SeanCoaker/Masters-Group-Project/Documentation/Milestone 3/chapter/design.tex

\chapter{Design}
        \label{ch:design}
        
            This chapter details the design decisions made for the project's hardware and software systems, which ultimately led to us being able to successfully implement our systems and meet the original requirements set out by our clients. The following sections will break down our final product into two systems, the walking aid device and the wearable device, detailing the design decisions made for each system, including which technologies were used and UML diagrams of the systems. We will begin by detailing the design choices we made that impact both systems before breaking down our design decisions that individually impact the walking aid and wearable devices.
        
            \section{Walking Aid Device}
            \label{sec:walking_aid}
        
                The walking aid device is a system that can be used to detect the movement of the walking aid. When the wearable device detects that the patient is walking, a message is sent to the walking aid device. Should the walking aid device detect that it is not moving when the patient is walking, it will play an audio reminder to the patient to take their walking aid with them. The following sections will detail the design choices we made for this system, where we will compare technologies that would have been suited to the system and which we chose to implement, as well as a UML design section which will include a class diagram of the developed software system and an activity diagram that demonstrates the workflow of the software that allows the device to meet our desired specification.
        
                \subsection{I2S Audio Shield}
                \label{subsec:i2s_audio_shield}
        
                    To handle the amplification of reminder audio files and transfer the analogue data of the reminder audio to an external speaker, we needed to select an audio shield. In this instance we selected the I2S Audio Shield \cite{unexpected_maker} on offer from Unexpected Maker, the creator of the TinyPICO development board that has been previously mentioned in section \ref{subsec:development_board}. What attracted the team to using this particular audio shield was the fact that it already included the necessary hardware for handling the audio reminder system. That is that it contains a micro-SD card slot for the reading of the user's reminder audio file, external speaker output pins, and an amplifier to increase the volume of the audio in readiness to be transferred to the external speaker. With all these hardware devices housed on one audio shield, it made the design of the walking aid device casing more simple than an alternative that may have needed separate modules for the amplification of audio and the reading of a microSD card. In addition to this, we assumed that acquiring separate hardware items from the same manufacturer would lead to a greater chance of our hardware devices communicating flawlessly with each other. To this end, we have not experienced any issues with the communication between the walking aid's TinyPICO and its audio shield. Therefore, we would say that in this instance, our assumption was correct.
                    
                    Alternative solutions could have taken the form of utilising the same ``MAX98357 I\textsuperscript{2}C Decoder and Amp'' \cite{unexpected_maker} as the one used by the I2S Audio Shield we selected but instead combining it with a separate dedicated micro-SD card reader, such as this offering \cite{ada_2022} from the well known embedded hardware manufacturer, Adafruit. The wiring and code development in this instance would have been identical, but we appreciated the fact that the Unexpected Maker solution houses the I\textsuperscript{2}C decoder and amplifier on the same board as the microSD card reader. Along with this, the I2S audio shield is of a similar form factor to the TinyPICO development board and made the 3D modelling and printing process a simpler process.
        
                \subsection{SD Card Reading Library - SdFat}
                \label{subsec:sdfat}
        
                    The decision to use the SdFat library by Bill Greiman \cite{greiman} was an unexpected one as Arduino provides a solution of SD card reading library \cite{arduino} which acts as a wrapper to the SdFat library for easier understanding and further abstraction of the underlying code. However, when testing the transfer of a 150 KB mp3 file to the SPIFFS storage location of the TinyPICO, we began to notice that the library was taking an abnormally long time to complete the process, especially with a file this small. Upon completing research on the transfer speeds of the Arduino SD library, it was clear to see that the library had not been tested or optimised adequately enough to be used for the fast transferring of audio files from the microSD card to SPIFFS within our walking aid device. Discussion of these issues is widespread \cite{fat16lib_2011,drdooom_2019} with one GitHub user claiming that the SdFat library is ``85 times faster'' \cite{kas2_2018} than the Arduino SD library. Our testing demonstrated transfer times of the 150 KB mp3 file from the microSD card to SPIFFS at around 150 seconds for the Arduino SD library, and around 12 seconds for the SdFat library. More information on this is viewable within the testing section of this document. But with such a stark difference in transfer rates, and with fast transfer rates being crucial for the prompt initialisation of our systems, we felt that the SdFat library was the most appropriate solution for our purposes.
        
                \subsection{Physical Design}
                \label{subsec:Design_Decisions_walking_aid}
        
                    Upon clarifying the physical needs and requirements of the device, it was decided that the walking aid device had to be adaptable between different walking aids, such as a walking sticker or Zimmer frame. The form factor was an especially important priority, as a small/minimal footprint would minimise any potential problems or complications with the users. With this in mind, and with components at hand, the design was made with minimal overhead over the physical size of the items we had at hand. 
        
                    \input{graphics/cad/walkingaid_0.tex}
        
                    The design was made as modular as possible, to allow for changeable parts, and to make it inter-operable for different walking aids and mounting/battery options. The mounting options were inspired by the GoPro style of handlebar mount, this was chosen due to its simplicity, and the sturdiness of attachment which will help with the reading from our accelerometers. The mount was scaled down to be more appropriately attached to a walking stick or Zimmer frame, but as mentioned can be easily swapped and modified to work with bigger or smaller tubes/frames.
        
                    To fulfil the specification, and allow for familiar voices to remind the users, a MicroSD card was chosen as described above. This required easy access to the card slot, which had to be intuitive and accessible without disassembly of the device.
        
                    \input{graphics/cad/walkingaid_0_1.tex}
        
                    Further considerations include easy access to the MicroUSB port. This port is required for programming/updating the device, as well as being an option for powering the device if no battery is wanted/needed, or a 5v source is available (such as a large, portable power bank).
        
                    As noted, the current prototype has no battery support, but the design decision for this walking aid device is to offer swappable end cases, this helps with modularity to allow for different mounts and attachments, but with a through-hole for wiring, this allows for future implementations of battery-based sources, such as replaceable batteries or rechargeable internal cells.

                \subsection{Prototype}
                \label{subsec:prototype_walking_aid}
        
                    As with the wearable device, assembly was made using standard M3 sized bolts, this time 35mm long to ensure suffcient length to attach the the front and rear endcasing to the midframe. This designed allows assembly to be done rather easily, and again utilising the self-tapping capabilities of the ABS plastic to retain the screws.
        
                    Before assembly, the speaker wires had to be attached to the terminal of the Audio Shield, as the TinyPico would block access to it later on in assembly. The wires had to be fed through the access hole in the midframe, to allow access as well as boost the internal area that the speaker can leverage for stronger sound.
        
                    \input{graphics/prototype/walkingaid_1.tex}
        
                    The front encases the 40mm driver, and the 4 screws attach it to the midframe securely without further adhesives, initially we had thought that spacers may be needed to stop unnecessary movement, but we instead opted for friction fit tolerances during design, which allowed for this step to be skipped and for an easier assembly process. The original speaker wiring is used, to ensure the correct gauge and rating is used and therefor safe.
        
                    The TinyPico with the accompanying soldered ADXL wiring is then added to the assembly. Side brackets are included in the complex midplate, that stop the boards from moving inside the casing. This is critical as we did not want internal movement to affect the sensitive accelerometer, and due to the SD Card and MicroUSB port requiring precise cutouts in order to remain accessible.
        
                    \input{graphics/prototype/walkingaid_2.tex}
        
                    The rear endcasing can then be attached, in the same manner as the front casing. This self taps into the designed screw holes, and ensures that both sides of the device are securely clamped and in place.

                \subsection{UML}
                \label{sec:uml_walk_aid}
                
                    This section will break down the software systems utilised in the walking aid device into formal language representations. These will take the form of a class diagram, which will illustrate the relationships between each of the classes developed for the system, and an activity diagram which will demonstrate the sequence of events that will take place in the system and how they are handled. We hope that this section will help the reader to understand the software system in a broken down, step-by-step manner and to gain an understanding of our rationale for programming choices that helped us to fulfil the user requirements. The class diagrams will be followed by an explanation of the role of each class and its functions, with the activity diagram also being accompanied by a body of text that establishes in natural language the sequence of events that will take place in the software system and how they are processed.
        
                    \subsubsection{Class Diagram}
                    \label{subsubsec:class_diagram_walking_aid}
        
                        To demonstrate how the classes within the software are laid out and how they communicate with one another to make up the whole system, we include here a class diagram. Following the class diagram, we will include documentation on each class and their functions towards benefiting the functionality of the system. 
        
                        \clearpage
                        \thispagestyle{empty}
                        \begin{landscape}
                            \input{graphics/walking_aid_uml.tex}
                        \end{landscape}
        
                        \paragraph{WalkAidSketch}\mbox{}
        
                            This is the main controller of the whole walking aid system and provides the functionality of the setup and loop functions that are required by Arduino systems. It has a composition relationship with the WalkAidAccelerometer, WalkAidCommunications, and the WalkAidAudio classes. Thus, the WalkAidSketch class cannot function without the existence of those classes, and those classes cannot function without the existence of the WalkAidSketch class. The WalkAidSketch class handles the initialisation of the other classes within the setup function, before ensuring that each time the loop function is called, checks are made to see if reminder messages have been received and if so, are responded to accordingly.
        
                        \paragraph{WalkAidAccelerometer}\mbox{}
        
                            The WalkAidAccelerometer class is responsible for the initialisation of the accelerometer, and the reading of the accelerometer data. The class keeps track of when a step was last taken to avoid the audio reminder being played if the walking aid is moving. It has a composition relationship with the ADXL345 class meaning that neither class could function properly without the existence of the other. This class also relies on the existence of the WalkAidSketch to exist itself.
        
                        \paragraph{WalkAidCommunications}\mbox{}
        
                            The WalkAidCommunications class is responsible for the initialisation of the ESP-Now communication protocol to establish a connection to the wearable device. When a reminder message is received, the reminder variable is set to true to allow the WalkAidSketch to check for a step in the previous period of time or in the future period of time. Should a reminder need to be played but the user is deaf, this class will send a message back to the wearable device prompting it to vibrate. This class is initialised in the WalkAidSketch class and does not exist unless that class exists. Therefore, it is part of a composition relationship with the WalkAidSketch.
        
                            The WalkAidCommunications class also makes use of the DebugLED class to ensure that the user is notified of any issues in initialising the communications protocol on boot. It has a composition relationship with the DebugLED class to allow for the LED to be configured should an error occur with the initiation of the communication protocol.
        
                        \paragraph{DebugLED}\mbox{}
        
                            The DebugLED class exists to handle the configuration of the TinyPICO's onboard LED to indicate whether the communication protocol is working or not. It is initialised in the WearableDeviceSketch class and is, therefore, part of a composition relationship with the WearableCommunications class. More specifically, an instance of the DebugLED class cannot exist without an instance of the WearableCommunications class.
        
                            The DebugLED class also holds a composition relationship with the TinyPICO helper library to allow for the configuration of the LED.
        
                        \paragraph{WalkAidAudio}\mbox{}
        
                            This class handles the initialisation of the SDToSPIFFS class to allow for the transferring of an audio SD file to the SPIFFS memory. Afterwards, it initialises all the necessary classes to interpret the mp3 audio file and play it. This class creates pointers to the AudioFileSourceID3, AudioFileSourceSPIFFS, AudioGeneratorMP3, and AudioOutputI2S classes. It has an aggregation relationship with these classes as it is responsible for their deletion due to them being pointer variables. It also holds a composition relationship with the SDToSPIFFS class, which is utilised for the transferring of the audio file from the SD card to the SPIFFS storage. 
        
                        \paragraph{SDToSPIFFS}\mbox{}
        
                            This class is responsible only for the transferring of the SD card audio file to the SPIFFS storage. It is part of a composition relationship with the WalkAidAudio class, due to it relying on being initialised in that class to exist. It also holds a composition relationship with the SdFat class, which we discussed in section \ref{subsec:sdfat}, to handle the more intricate SD card functions. 
                        
                        \newpage
        
                    \subsubsection{Activity Diagram}
                    \label{subsubsec:walking_aid_activity}
        
                        The following is an activity diagram that demonstrates the workflow of the walking aid software system. It demonstrates in a graphical way how the system operates in a step-by-step manner. Accompanying the activity diagram will be a body of text that will describe the overview of the activity diagram in natural language.
        
                        \input{graphics/walking_aid_activity.tex}
                    
                        The system begins as soon as the device is powered on. The first process that the system runs is the transferral of the SD audio file to the SPIFFS storage location for quicker access later on. If an error is detected with the process of transferring the audio file from the SD card to SPIFFS, then the system is left in a non-functional state. The system then attempts to initialise the ESP-Now communication with the wearable device. If this is unsuccessful then it will sit in an inactive state. Otherwise, it will attempt to initialise the accelerometer and begin the loop function of the sketch. 
        
                        For each pass of the loop function, the system first checks to see if a reminder message has been received from the wearable device. This message states, ``The wearable device is moving, is the walking aid device moving also?''. At this stage, the system checks if the time of the last detected step happened within the last developer's set period of time. If a step had been detected in that time, then we skip to the end of the loop and check again for movement in the walking aid to update the last time a movement was detected. Otherwise, we then run a loop for the developer set period of time to check if movement is then detected. This allows the user time to get to their walking aid before having a reminder played or a vibration played through the wearable device. If movement was not detected in that period of time, then we play the audio reminder or send a vibrate message to the wearable device if the user is deaf. If movement was detected then we skip playing the audio or sending a vibrate message and move to the end of the loop. In all instances, the end of the loop signifies that the check for movement should occur again. As previously stated, this is to update the timestamp of the last movement detected. Once this is complete, we move back to the check for reminder message step to start the loop again.
        
                        To terminate the execution of the system prematurely, the device can be powered off. We may not have followed the etiquette of activity diagrams to demonstrate this, but we wanted to demonstrate that the system remains functional in a constant loop unless the device is powered off. We added a second initial activity of turning off the device to demonstrate this, where a power off device activity is run and we finish in a state where the device is powered off and non-functional.
                    
            \section{Wearable Device}
            \label{sec:wearabledevice}
        
                The wearable device can be worn on the limbs of the patients to identify when the patient has begun walking. When walking is detected, communication occurs between the walking aid and wearable device to identify if the walking aid device is moving also. 
        
                \subsection{Walking Detection Technique - Single-Tap Detection}
                \label{subsec:walking_detection_technique}
        
                   With the movement detection of the walking aid device, it was an obvious decision to utilise the single-tap detection feature of the ADXL345 accelerometer. We assume that the walking aid will take the form of a walking stick or Zimmer frame-like structure, with movement likely to include lifting and placing. The placing event will cause a change in gravity through the Z-Axis of the accelerometer, and thus will allow the accelerometer to notice a tap is detected.
        
                   The decision of what system to use to detect movement in the wearable device was less simple. Options included using a similar single-tap detection system, a system that utilises changes in acceleration to detect walking or a system that uses the Bluetooth Low Energy (BLE) technology of each device to measure changes in distances between them. With the option of utilising BLE technology to detect walking, we would have needed to also utilise an accelerometer on one of the devices still to gain an understanding of which device was moving. However, the use of BLE technology for this use case would have been inadequate due to its potential for distance calculation inaccuracies of up to several metres \cite{Fachri_2019}. 
        
                   Therefore, we were left with using the ADXL345 accelerometer for the detection of the user walking. To decide on which solution of accelerometer system to use, we decided to develop both the single-tap detection system and the acceleration change detection system and compare them in real-world testing. For our system, the single-tap detection system seemed to work better in attempting to detect walking, whereas the system attempting to detect changes in acceleration struggled with also detecting any movements in the accelerometer. The single-tap detection system would also be beneficial to us as it would be implementable on both the walking aid and wearable devices. Another benefit to the single-tap detection solution is that it allows versatility as to where the wearable device can be placed, with testing proving that the devices can detect walking on both the user's wrist and their ankle. 
        
                   Ultimately, we decided to implement the single-tap detection system within the wearable device to detect when the user was walking. We make use of a system that checks if the user makes 5 steps within 10 seconds to meet the user requirement of reminders only being played if the user has moved over a metre without their walking aid. If they do, then we send a message to the walking aid device to play an audio reminder to the patient to take their walking aid with them if the walking aid device has not detected movement. The main benefit of this system is its versatility to be worn on the user's wrist or ankle, and it provided the foundations for the similar system that has been developed for the walking aid device. In future, we would like to explore the use of the aforementioned ultra-wideband technology (UWB). Due to its distance measurement error being within 10 cm \cite{uwb_accuracy}, it would have been interesting to implement this within the wearable device, and into the walking aid device working in conjunction with an accelerometer to detect if the walking aid is moving.
        
                \subsection{Physical Design}
                \label{subsec:Design_Decisions_wearable}
        
                    As with the walking aid device, the design was formulated around a minimalistic form factor around the components that needed to be present, in this case, the TinyPico, ADXL, and vibration motor. This prototype needed to be of a particularly small form factor; the client made it clear that patients aren't always happy with new, large and obtrusive objects on their bodies, so the more natural we could make it, the better it would be. This device is very tightly packed, with the components in very short distances of one another, although this could be an issue with electrical shorts, during assembly there will be insulating factors included, that will stop this from happening.
        
                    \input{graphics/cad/wearable_components_1.tex} %%also includes endcase
        
                    A similar approach was taken regarding the modular design, with an end-housing that can be quickly and easily changed. We designed a base end-plate from which all attachments are based, and will include it in the deliverables to ensure the client can adjust and create more as needed from our working template.
        
                    \input{graphics/cad/wearable_0.tex}
        
                    We have designed and printed two different mounting options to begin with, the first being a "clip-on" style attachment, that allows the wearable device to be clipped into pockets, clothing, or existing bands or straps the user may be wearing. This was designed to be a tight, friction fit between the casing and the clip, to ensure there is less chance of the item becoming loose over time.
        
                    \input{graphics/cad/wearable_clip_0.tex}
        
                    The second attachment option is a watch strap mount. This allows the wearable device to be used with any standard 22mm watchstrap, and the idea behind this is to allow for a more comfortable, and familiar feel on the arm. Patients aren't always happy trying new things due to their condition, but this should allow for existing watch straps to be used, and make them feel at home with their new device.
        
                    \input{graphics/cad/wearable_strap_0.tex}
        
                \subsection{Prototype}
                \label{subsec:Prototype_wearable}
        
                    The prototype was assembled using M3x8 stainless steel screws, which allowed for easy assembly and self-tapping into the soft interior plastic, which was toleranced for this. In the future, it would be ideal to use heat-set inserts, to ensure the longevity of the threading.
        
                    \input{graphics/prototype/wearable_0.tex}
        
                    The wiring and soldering were done before assembly, with approximate but accurate measurements of 26awg silicone wire, to allow for a minimal form factor and to fit in the small enclosure. Silicone wire was used to ensure tight bends and cable management could be achieved.
        
                    \input{graphics/prototype/attachments.tex}
        
                    We have created the two available attachments, as previously described, a clip that can be worn on any existing bands, pockets or clipped directly to clothing/sleeves. Also shown is the watch strap attachment, without the device to show off the geometry of the design
        
                    \input{graphics/prototype/watchstrap_0.tex}
        
                    Shown above is the wrist strap attachment, which allows the use of regular 22mm watch bands, using standard push pin connectors. This allows the patient to be more comfortable, and use existing watch straps they may already own and be accustomed to.

                \subsection{UML}
                \label{sec:uml_wearable}
                
                    This section will break down the software systems utilised in the walking aid device into formal language representations. These will take the form of a class diagram, which will illustrate the relationships between each of the classes developed for the system, and an activity diagram which will demonstrate the sequence of events that will take place in the system and how they are handled. We hope that this section will help the reader to understand the software system in a broken down, step-by-step manner and to gain an understanding of our rationale for programming choices that helped us to fulfil the user requirements. The class diagrams will be followed by an explanation of the role of each class and its functions, with the activity diagram also being accompanied by a body of text that establishes in natural language the sequence of events that will take place in the software system and how they are processed.
        
                    \subsubsection{Class Diagram}
                    \label{subsubsec:class_diagram_wearable}
        
                        Similarly to the walking aid device section, this section will include the class and activity diagrams of the wearable device. Each diagram will be accompanied by a body of text that explains the diagram in a natural language format.
        
                        \clearpage
                        \thispagestyle{empty}
                        \begin{landscape}
                            \input{graphics/wearable_uml.tex}
                        \end{landscape}
        
                        \paragraph{WearableDeviceSketch}\mbox{}
        
                            This is the main sketch for the wearable device system and implements the setup and loop functions necessary for an Arduino system. It creates instances of the WearableAccelerometer and WearableCommunications class to provide the full functionality of the wearable device. The setup function initialises both classes with the developer's selected parameters. Following this, the loop function handles the calls to check if the user has moved more than 5 steps within a period of time set by the developer. If they have, then the communications object is called to handle the broadcasting of a reminder message to the walking aid device.
        
                            The WearableDeviceSketch has a composition relationship to both of the other classes as it plays the role of instantiating both objects. Therefore, without the existence of the WearableDeviceSketch, an object of the other two classes would not exist.
        
                        \paragraph{WearableCommunications}\mbox{}
        
                            The WearableCommunications class handles all the functionality needed to broadcast a message to the walking aid device. Once it is initialised by the WearableDeviceSketch class with a reminder message to send and a MAC address to send the message to, its sendReminderMessage function can be called to broadcast a reminder message when the user has walked more than 5 steps in a specified period of time set by the developer. It is also initialised with the details of the walking aid device as a peer to allow incoming communication. The WearableCommunications class has a composition relationship with the DebugLED class to allow for the LED to be configured should an error occur with the initiation of the communication protocol.
        
                            This class is also part of a composition relationship with the WearableDeviceSketch class and therefore an object of it cannot exist unless the WearableDeviceSketch class is instantiated.
        
                        \paragraph{DebugLED}\mbox{}
        
                            The DebugLED class exists to handle the configuration of the TinyPICO's onboard LED to indicate whether the communication protocol is working or not. It is initialised in the WearableDeviceSketch class and is, therefore, part of a composition relationship with the WearableCommunications class. More specifically, an instance of the DebugLED class cannot exist without an instance of the WearableCommunications class.
        
                            The DebugLED class also holds a composition relationship with the TinyPICO helper library to allow for the configuration of the LED.
        
                        \paragraph{WearableAccelerometer}\mbox{}
        
                            Controlling the functionality of the walking detection, this class utilises the ADXL345 accelerometer library to detect single-taps or gravitational changes through the accelerometer. Once it is initialised with threshold values and a value for the period of time used to check for 5 steps, the poll function can be called by the WearableDeviceSketch to check for steps. Each time a step is detected, the addStepToCounter function is called to add to the total number of steps detected. If a step is detected, and it has taken more than the period of time since the first step is detected, then the timer is reset. Otherwise, if the step counter is incremented and is still less than 5 steps, then we move on. However, if the step counter reaches 5 steps within the developer set period of time, then a true boolean value is returned to the WearableDeviceSketch to notify it that a reminder message should be sent to the walking aid device.
        
                            The class holds a composition relationship with the ADXL345 library to retrieve the necessary functionality for step detection. This class is also part of a composition relationship with the WearableDeviceSketch class, meaning that if an instance of the WearableDeviceSketch class does not exist then neither will an instance of this class. 
        
                        \newpage
        
                    \subsubsection{Activity Diagram}
                    \label{subsubsec:wearable_activity}
        
                        The following is an activity diagram that demonstrates the workflow of the wearable software system. The diagram demonstrates how the system attempts to detect that the user is walking in a step-by-step manner to provide clarity on how the software was developed for these purposes. Accompanying the diagram will be a body of text that describes the process in natural language.
        
                        \input{graphics/wearable_activity.tex}
        
                        The activity diagram demonstrates that the system begins when the device is powered on. The system begins by initialising the accelerometer with the configurations of the developer before attempting to initialise the ESP-Now communications protocol and registering the walking aid device as a peer for communication. If either of the ESP-Now steps fail then we end up in a state where the device is powered on but is not functional. 
        
                        If the communication initialisation is successful, then we begin the process of attempting to identify when the user is walking. We begin first by checking for a step, which checks if the accelerometer has detected a change in gravity. If it has not detected a step, then we loop back and check for a step again until we identify one. Otherwise, we increment the step counter before checking to see if the timer has started and if it has, then we check to see if the time since the first step was detected is greater than the period of time set by the developer. If the timer has not been started, or it has been greater than the developer specified period of time since the first step, we reset the timer and set the step counter back to 1 and start the check for step process again. Otherwise, we run a check to see if the step counter is now at 5 steps. If it is not, then we loop back to the beginning of the check for the step counter. If the step counter is indeed equal to 5, then we have reached the situation where the user has moved a considerable amount in the period of time set by the developer. We can therefore ascertain that the user is walking and send a reminder message to the walking aid device to check if the walking aid is moving as well.
        
                        Finally, despite not following activity diagram etiquette, we wanted to demonstrate how powering off the system is the only way to stop the device from being functional. The existence of a second initial activity that controls the powering off of the system demonstrates this and demonstrates how the rest of the system relies on the device being powered on.
        
            \section{Walking Aid \& Wearable Device Design Commonalities}
            \label{sec:both_devices}
        
                This section will contain information on the design decisions we made that impacted both the wearable and walking aid devices. This will include software and hardware decisions that allowed us to implement a communications system, that allowed us to keep device form factor and power usage to a minimum and a discussion of why we chose pieces of hardware that are common between both devices.
        
                \subsection{Development Board - TinyPICO}
                \label{subsec:development_board}
        
                    The development board for each device would provide the necessary communication between multiple hardware components to allow us to reach the originally defined user requirements. Due to our previous experience with ESP32 chips and due to the necessity of our devices being of a small enough form factor to fit on the limbs of patients and walking aids, we decided to use the TinyPICO development boards. Their use of ESP32 chips provides the basis for our communication system which utilises a Wi-Fi module and provides adequate pinouts to allow us to communicate to each hardware device that we include within our systems. This is all achieved whilst keeping power usage to a minimum and allowing us to meet the client's requirement of creating devices that can operate for a substantial amount of time without the need for battery replacements. The 240MHz dual-core chip that is the ESP32, would provide performance that allows our system to react to incoming communication from the Wi-Fi module or accelerometer promptly to provide a responsive system for our clients. The vast documentation supporting the development of embedded systems using ESP32s was instrumental in the success of our project, and we feel that the decision to utilise TinyPICO development boards was the correct one because of this. We were also influenced to use TinyPICO development boards due to Swansea University allowing us to borrow two boards at no extra cost, which ultimately allowed us to remain within our £150 budget. Finally, the TinyPICO boards also provide a built-in LED which we utilised throughout project development for debugging purposes.
        
                \subsection{Programming Language - Arduino C (C/C++)}
                \label{subsec:programming_language}
        
                    We decided to utilise the Arduino C (C++) programming language rather than using MicroPython to develop our embedded software due to C++'s superior efficiency over Python for the development of embedded software \cite{github_2014, dicola}. Other tools such as PlatformIO would have provided the basis to allow us to utilise C++ for our software development, but due to the benefits of our team having previous experience of using the Arduino IDE to develop embedded systems, especially in the field of software development with ESP32 chips, we felt that our project would be better suited to being developed utilising the Arduino ecosystem. We were also aware that the handover of this project would mean that another team would be able to take on the role of advancing our code and felt that C++ provided the best platform for developing smaller and more self-explanatory code across multiple header and implementation files. This would mean that any developers that attempt to further develop our code in future, should find it rather simple to identify what each class and block of code is attempting to accomplish.
        
                \subsection{Accelerometer - Adafruit ADXL345}
                \label{subsec:accel}
        
                    Within this project, the accelerometer would provide the basis for identifying the movement of the patient and the walking aid. The vast documentation supporting the development of embedded systems using ADXL345 accelerometers was a substantial factor in why we opted to include them in our systems. They provide the functionality for the detection of various changes in acceleration such as activity detection, free-fall detection and single-tap and double-tap detection. The single-tap detection feature of the ADXL345 provides the basis for movement detection on both devices since it can detect changes in gravity to identify when a step has been taken. The single-tap detection feature also allows the system to still be utilised whether the user is wearing the wearable device on their wrist or ankle, with the single-tap detection feature also being able to detect when the walking aid is being lifted and placed back on the ground. The free-fall detection feature provided by the ADXL means that future developers will be able to easily implement a free-fall detection system, which would allow the client to have their stretch goal implemented into the project. We opted to use the ADXL345 over other accelerometers as it is one of the newer offerings of accelerometers from the well renowned and reliable brand, Adafruit. Because of this, the accelerometers were relatively easy and quick to source, whilst only costing £7 per unit and allowing us to remain within our £150 budget. Finally, with the walking aid's TinyPICO already having its Serial Peripheral Interface and 3.3V power pinouts being utilised by the I2S audio shield, the ADXL345 allowed us to use the TinyPICO's I\textsuperscript{2}C interface for communication between the accelerometer and the development board and allowed us to use the 5V pinout provided by the TinyPICO to power the ADXL345 due to its built-in voltage regulator.
        
                \subsection{Communication Protocol - ESP-Now}
                \label{subsec:esp_now_comms}
        
                    Within the details specified in our Milestone 2 interim progress report, we classified the advantages and disadvantages of various options for communication protocols for use within our project. The first of those communication protocols was ESP-Now, a communication technology developed by the creators of the ESP32 chip, Espressif, which utilises the ESP32's Wi-Fi module to communicate with other devices that contain ESP32 chips \cite{esp-now_overview}. The other two communication protocol options we could have utilised were Bluetooth Low Energy (BLE) and Ultra-wideband (UWB). Despite considerations to include the use of UWB within our project, it would have been far too expensive for us to implement, and thus we instantly rejected the notion of using UWB within our project. Therefore, we were left with a decision to either utilise BLE or ESP-Now for the communication standard between our walking aid and wearable device. For the rest of this section, we will detail the advantages and disadvantages of using ESP-Now for our communication system, with comparisons to BLE, before finally detailing why we ultimately opted to utilise ESP-Now.
        
                    \newpage
                    \subsubsection{Advantages and Disadvantages of ESP-Now with comparisons to BLE}
                    \label{subsubsec:esp_now_advantages_disadvantages}
        
                        \vspace{2em}
                        \input{tables/nowTable.tex}
                        \vspace{5em}
        
                        We ultimately decided to use ESP-Now as our communication protocol due to its ease of implementation and since it allows sketch sizes to be smaller \cite{random_nerd_tutorials} than the sketch sizes of BLE \cite{kolban_2018}. The significance to sketch sizes being smaller is that they allow for the larger memory storage spaces accounting for larger audio reminder files, as well as providing more responsive code for what is a time-sensitive system. The lower throughput that ESP-Now provides in comparison to BLE should not be noticeable within our system because we only ever send one-word messages between our devices at a given time. However, the lower power efficiency of ESP-Now in comparison to BLE is a considerable disadvantage for use within this system. Having said this, ESP-Now is still regarded as being a low power solution and should still mean that the patient or carer will not need to remember to replace the batteries in their devices too often.

                \subsection{Power}
                \label{subsec: Power}
                    Our prototypes will not include any battery or portable power source support built-in, this decision was made due to the limited time and budget we had. Our vision, research and hardware support 1S Lithium Polymer (LiPo) batteries as standard and the TinyPico is designed to be used with this power source in mind. Unfortunately, researching safe battery charging circuits as well as proper battery care was not something we had the time for and will leave as an attainable stretch goal if this project were to gain further funding or time budgets.
        
                    1S LiPos are compact and offer excellent discharge currents which would make it ideal for our high wattage speaker, although adjusting speaker size can reduce the battery requirement quite significantly, and can be considered later on with further research and testing.
        
                    Our prototypes are powered by the same MicroUSB, 5V port that is used for programming and updating the device, to facilitate testing, these will run off of portable power banks with USB outputs, to ensure reliable voltage and amperage are provided to our devices to reduce potential issues during testing.
        
                \subsection{Prototyping}
                \label{subsec: Prototyping}
                
                    The software package used for designing the prototypes was chosen to be Autodesk Fusion 360 \cite{autodesk_2021}, as well as how pervasive it is within the 3D Printing community.
        
                    Where possible, we ensured that we used accurate existing models. This allowed us to make progress faster, as working out and modelling tight tolerances on PCB components wasn't always required. 
        
                    For the hardware that we could not find models for, such as the speaker, i2s audio shield, and vibration motor, critical dimensions were taken using Vernier callipers, and by cross-checking datasheets for each or similar devices.
        
                    For both devices, a large emphasis was placed on creating an enclosure for the electronics with a minimal, but modular form factor. As shown in their respective sections, the devices were designed to effectively house and protect the existing components, as well as allow for future expansion using modular systems and design choices, such as extendable mid plates and standard sized screws and fasteners.
        
                    Once designs for the enclosures were created, they were sliced and converted to gcode (file format used by 3D Printers, CNC routers, and other kinematic machines) using the open-source software package SuperSlicer \cite{merill_2022}, and then printed on a custom VoronDesign 0.1 CoreXY Fused Filament Deposition (FDM) 3D Printer. SuperSlicer was chosen due to our team's experience with the software, as well as already having a previously tuned profile for the machine.
        
                    The printing material was chosen to be Acrylonitrile butadiene styrene (ABS), a ubiquitous thermoplastic most often used with injection moulding in everyday objects due to its high impact resistance and thermal/chemical resistance. It used to be the plastic of choice for hobby-grade 3D Printing, however, it is becoming less common vs easier to print, and weaker/biodegradable plastics like Polylactic Acid (PLA) or Polyethylene terephthalate (PETG). We chose to continue with ABS, as our printer is cable of printing this more exotic material, and its properties will allow us to undertake stricter impact and resistance testing.             
                
            \newpage
        
            \section{Class Documentation - Walking Aid Device}
            \label{sec:class_documentation_walk_aid}\mbox{}
        
                \input{chapter/docs/walking_aid/sdtospiffs.tex}
                \newpage
                \input{chapter/docs/walking_aid/walkaidaccel.tex}
                \newpage
                \input{chapter/docs/walking_aid/walkaidaudio.tex}
                \newpage
                \input{chapter/docs/walking_aid/walkaidcomms.tex}
                \newpage
                \input{chapter/docs/walking_aid/debugled.tex}
                \newpage
                \input{chapter/docs/walking_aid/sketch.tex}
                \newpage
        
            \section{Class Documentation - Wearable Device}
            \label{sec:class_documentation_wearable}\mbox{}
        
                \input{chapter/docs/wearable/wearableaccel.tex}
                \newpage
                \input{chapter/docs/wearable/wearablecomms.tex}
                \newpage
                \input{chapter/docs/wearable/debugled.tex}
                \newpage
                \input{chapter/docs/wearable/sketch.tex}
                \newpage
