SeanCoaker/Masters-Group-Project/Documentation/Milestone 2/chapters/requirements.tex

\chapter{Requirements} \label{ch:Requirements}

In this section, we will include the functional and non-functional requirements from our Milestone 1 document \cite{coaker}. We will also include an extra column within the tables for both functional and non-functional requirements to detail what progress has been made towards implementing each requirement so far. These requirements were previously accepted by the client prior to the submission of our Milestone 1 document. Despite the issues and delays we have faced with the procurement of hardware, we believe that we are still on track to meet the requirements that we listed in our milestone 1 document \cite{coaker}. Therefore, we did not feel it necessary to make any amendments to our previously listed requirements. Our amended schedule in section \ref{chap:schedule} demonstrates our confidence in completing the work on time as well as demonstrating how important it was for us to complete development before and after we attained our full list of hardware.

\afterpage{%
    \clearpage% Flush earlier floats (otherwise order might not be correct)
    \thispagestyle{empty}% empty page style (?)
    \begin{landscape}% Landscape page
        \centering % Center table

        \section{Functional Requirements} \label{sec:func_requirements}
        \input{tables/f_reqs}

        \noindent
        \begin{tabularx}{0.9\linewidth}{rXXXXX}
           &\textsf{N/A}&\textsf{Started}&\textsf{Behind Schedule}&\textsf{Good Progress}
           &\textsf{Completed}\\[2mm]
           \textsf{FREQ1}       & \Mark{200}\\[-4mm]
           \textsf{FREQ2}    & \Mark{10}\\[-4mm]
           \textsf{FREQ3}    & \Mark{100}\\[-4mm]
           \textsf{FREQ4}   & \Mark{100}\\[-4mm]
           \textsf{FREQ5}       & \Mark{150}
        \end{tabularx}

        \pagebreak

        \section{Non-Functional Requirements} \label{sec:non_func_requirements}
        \input{tables/n_f_reqs}

        \noindent
        \begin{tabularx}{0.9\linewidth}{rXXXXX}
           &\textsf{N/A}&\textsf{Started}&\textsf{Behind Schedule}&\textsf{Good Progress}
           &\textsf{Completed}\\[2mm]
           \textsf{NONFREQ1}       & \Mark{200}\\[-4mm]
           \textsf{NONFREQ2}    & \Mark{150}\\[-4mm]
           \textsf{NONFREQ3}    & \Mark{150}\\[-4mm]
           \textsf{NONFREQ4}   & \Mark{200}\\[-4mm]
           \textsf{NONFREQ5}   & \Mark{200}\\[-4mm]
           \textsf{NONFREQ6}   & \Mark{200}\\[-4mm]
           \textsf{NONFREQ7}   & \Mark{150}\\[-4mm]
           \textsf{NONFREQ8}       & \Mark{10}
        \end{tabularx}

    \end{landscape}
    \clearpage% Flush page
}
% \vspace{1em} \input{./tables/f_reqs.tex} \vspace{5em}

% \section{Non-Functional Requirements} \label{sec:non_func_requirements}

% \vspace{1em} \input{./tables/n_f_reqs.tex} \vspace{5em}
