SeanCoaker/Masters-Group-Project/Documentation/Milestone 3/graphics/cad/walkingaid_0.tex

\begin{figure}[H]
\centering
\begin{minipage}{.5\textwidth}
  \centering
  
  \captionsetup{width=0.8\linewidth, justification=centering}
  \centering
  \captionof{figure}{Assembled walking aid device}
  \label{fig:walkingaid_1}
\end{minipage}%
\begin{minipage}{.5\textwidth}
  \centering
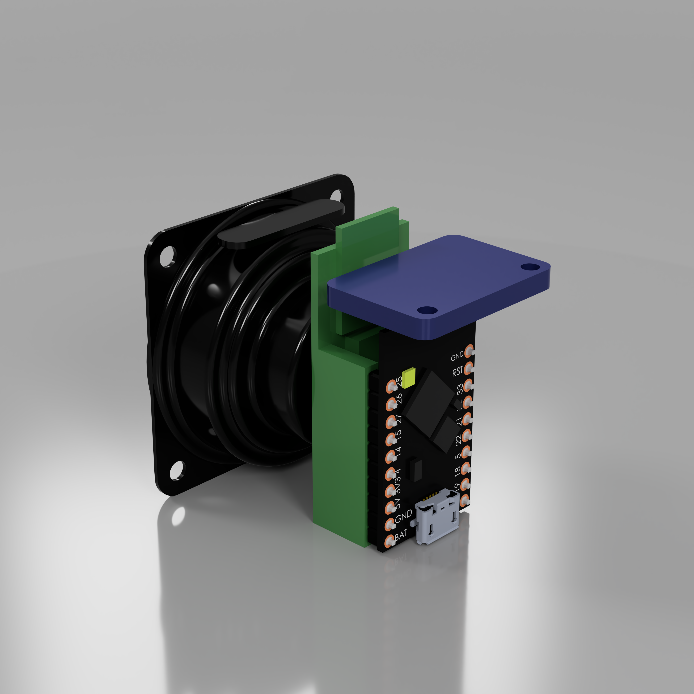
[picture p5: Documentation/Milestone 3/graphics/cad/walkingaid_components_1.png]
  
  \captionsetup{width=0.8\linewidth, justification=centering}
  \centering
  \captionof{figure}{Walking aid device component layout}
  \label{fig:walkingaid_components_1}
\end{minipage}
\end{figure}
