SeanCoaker/Masters-Group-Project/Documentation/Milestone 3/graphics/cad/walkingaid_0_1.tex

\begin{figure}[H]
\centering
\begin{minipage}{.5\textwidth}
  \centering
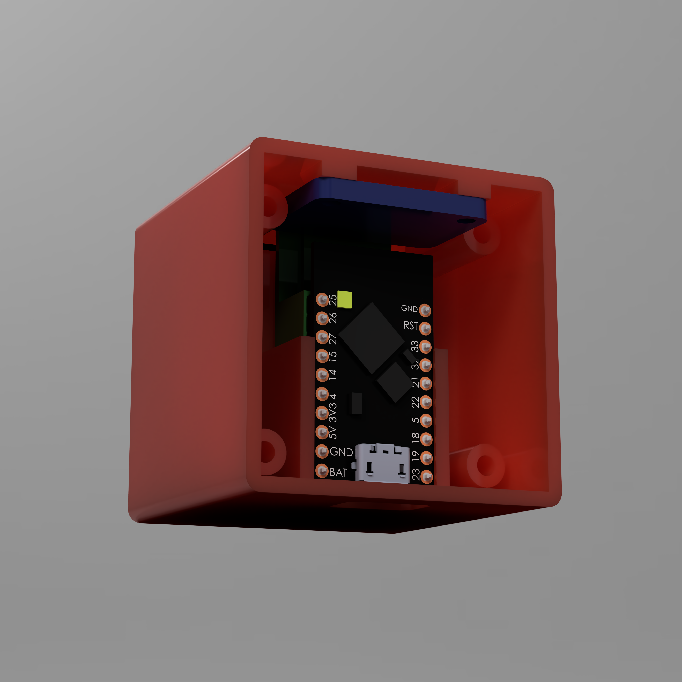
[picture p6: Documentation/Milestone 3/graphics/cad/walkingaid_interior_1.png]
  
  \captionsetup{width=0.8\linewidth, justification=centering}
  \centering
  \captionof{figure}{Walking aid interior view}
  \label{fig:walkingaid_interior_1}
\end{minipage}%
\begin{minipage}{.5\textwidth}
  \centering
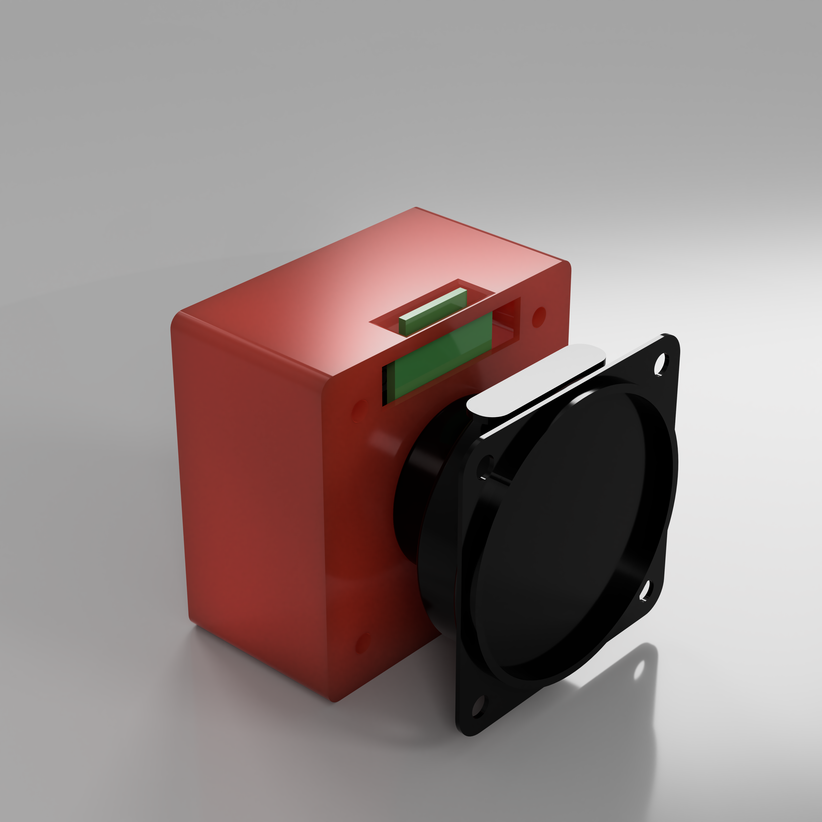
[picture p7: Documentation/Milestone 3/graphics/cad/walkingaid_midhousing_1.png]
  
  \captionsetup{width=0.8\linewidth, justification=centering}
  \centering
  \captionof{figure}{Walking aid mid housing layout}
  \label{fig:walkingaid_midhousing_1}
\end{minipage}
\end{figure}
