SeanCoaker/Masters-Group-Project/Documentation/Milestone 3/graphics/prototype/attachments.tex

\begin{figure}[H]
\centering
\begin{minipage}{.5\textwidth}
  \centering
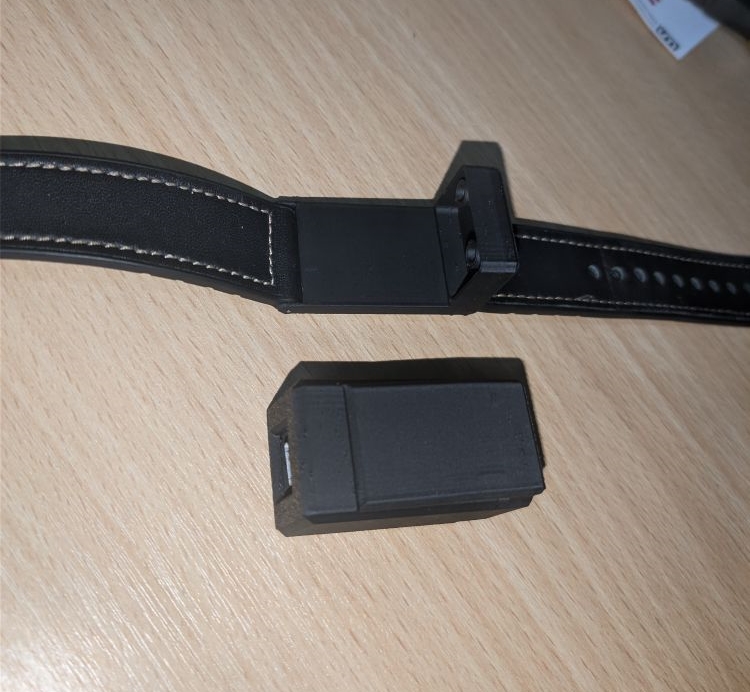
[picture p8: Documentation/Milestone 3/graphics/prototype/attachments.jpeg]
  
  \captionsetup{width=0.8\linewidth, justification=centering}
  \centering
  \captionof{figure}{Both currently available attachments}
  \label{fig:attachments_1}
\end{minipage}%
\begin{minipage}{.5\textwidth}
  \centering
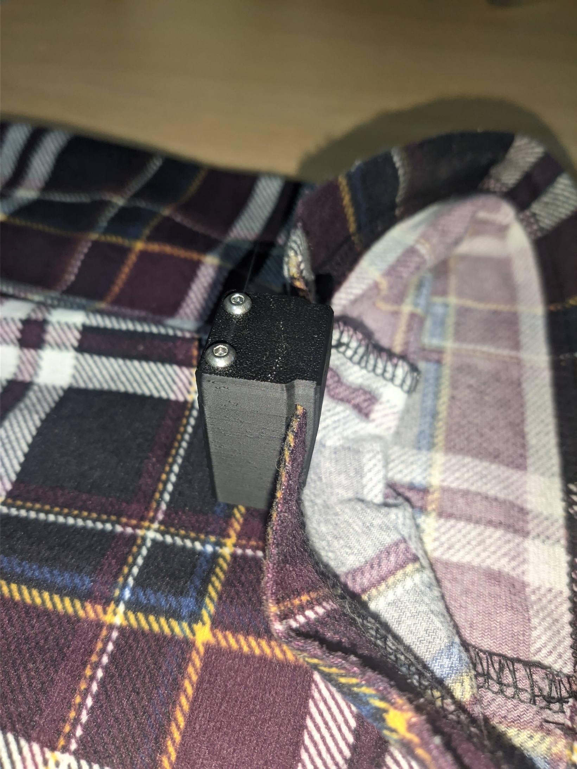
[picture p9: Documentation/Milestone 3/graphics/prototype/attachment_clip.jpg]
  
  \captionsetup{width=0.8\linewidth, justification=centering}
  \centering
  \captionof{figure}{Clip attachment in use}
  \label{fig:watchstrap_2}
\end{minipage}
\end{figure}
