SeanCoaker/Masters-Group-Project/Documentation/Milestone 3/graphics/prototype/walkingaid_1.tex

\begin{figure}[H]
\centering
\begin{minipage}{.5\textwidth}
  \centering
  
  \captionsetup{width=0.8\linewidth, justification=centering}
  \centering
  \captionof{figure}{Assembled walking aid device}
  \label{fig:walkingaid_proto_1}
\end{minipage}%
\begin{minipage}{.5\textwidth}
  \centering
  
  \captionsetup{width=0.8\linewidth, justification=centering}
  \centering
  \captionof{figure}{Assembled walking aid device, shown in hand}
  \label{fig:walkingaid_proto_2}
\end{minipage}
\end{figure}
