SeanCoaker/Masters-Group-Project/Documentation/Milestone 3/graphics/prototype/walkingaid_2.tex

\begin{figure}[H]
\centering
\begin{minipage}{.5\textwidth}
  \centering
  
  \captionsetup{width=0.8\linewidth, justification=centering}
  \centering
  \captionof{figure}{Internal wiring of the walking aid device}
  \label{fig:walkingaid_wiring}
\end{minipage}%
\begin{minipage}{.5\textwidth}
  \centering
  
  \captionsetup{width=0.8\linewidth, justification=centering}
  \centering
  \captionof{figure}{Rear endcasing of the walking aid device}
  \label{fig:walkingaid_rear}
\end{minipage}
\end{figure}
