SeanCoaker/Masters-Group-Project/Documentation/Milestone 3/graphics/prototype/watchstrap_0.tex

\begin{figure}[H]
\centering
\begin{minipage}{.5\textwidth}
  \centering
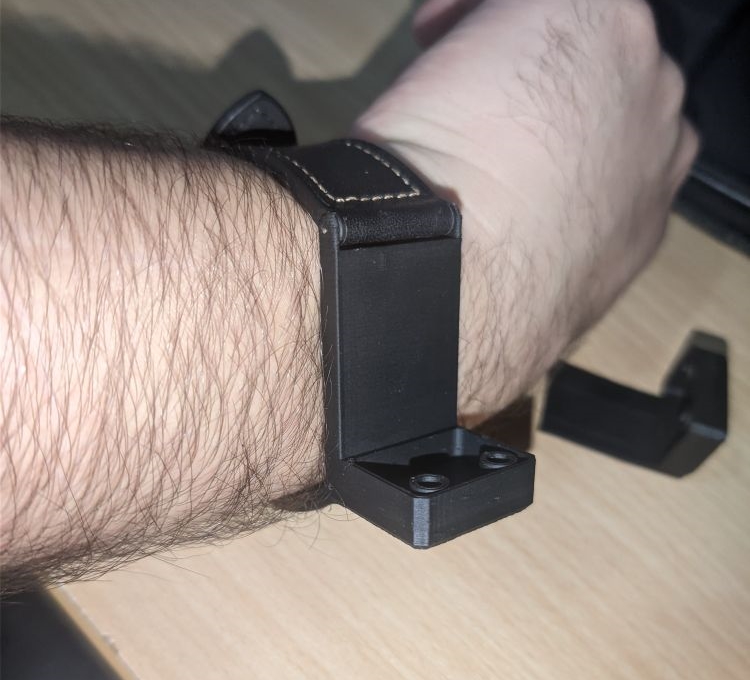
[picture p10: Documentation/Milestone 3/graphics/prototype/wriststrap_1.jpeg]
  
  \captionsetup{width=0.8\linewidth, justification=centering}
  \centering
  \captionof{figure}{Watchstrap being worn}
  \label{fig:watchstrap_2}
\end{minipage}%
\begin{minipage}{.5\textwidth}
  \centering
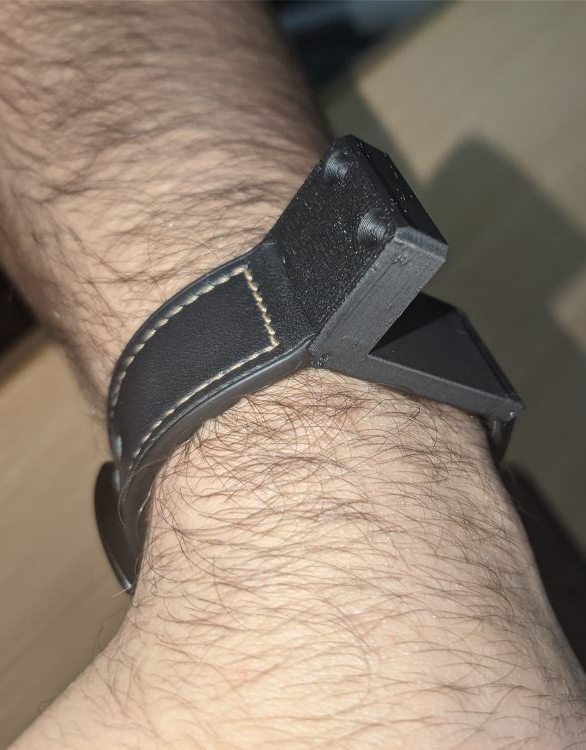
[picture p11: Documentation/Milestone 3/graphics/prototype/wriststrap_2.jpeg]
  
  \captionsetup{width=0.8\linewidth, justification=centering}
  \centering
  \captionof{figure}{Watchstrap being worn}
  \label{fig:watchstrap_2}
\end{minipage}
\end{figure}
