SeanCoaker/Masters-Group-Project/Documentation/Milestone 3/graphics/prototype/wearable_0.tex

\begin{figure}[H]
\centering
\begin{minipage}{.5\textwidth}
  \centering
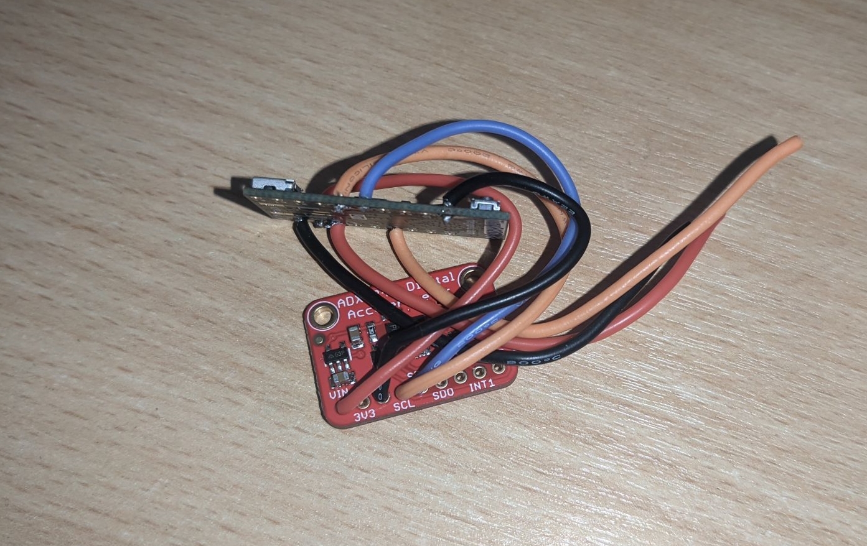
[picture p12: Documentation/Milestone 3/graphics/prototype/wearable_wiring.jpeg]
  
  \captionsetup{width=0.8\linewidth, justification=centering}
  \centering
  \captionof{figure}{Wearable device wiring}
  \label{fig:wearable_wiring_1}
\end{minipage}%
\begin{minipage}{.5\textwidth}
  \centering
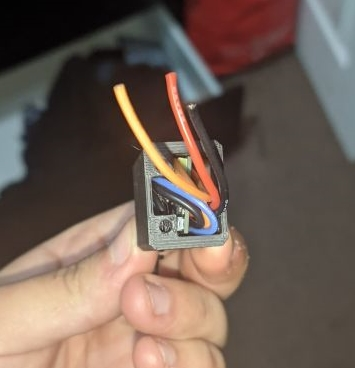
[picture p13: Documentation/Milestone 3/graphics/prototype/wearable_wiring2.jpeg]
  
  \captionsetup{width=0.8\linewidth, justification=centering}
  \centering
  \captionof{figure}{Wearable device internal wiring}
  \label{fig:wearable_wiring_2}
\end{minipage}
\end{figure}
