SeanCoaker/Masters-Group-Project/Documentation/Milestone 3/graphics/cad/wearable_0.tex

\begin{figure}[H]
\centering
\begin{minipage}{.5\textwidth}
  \centering
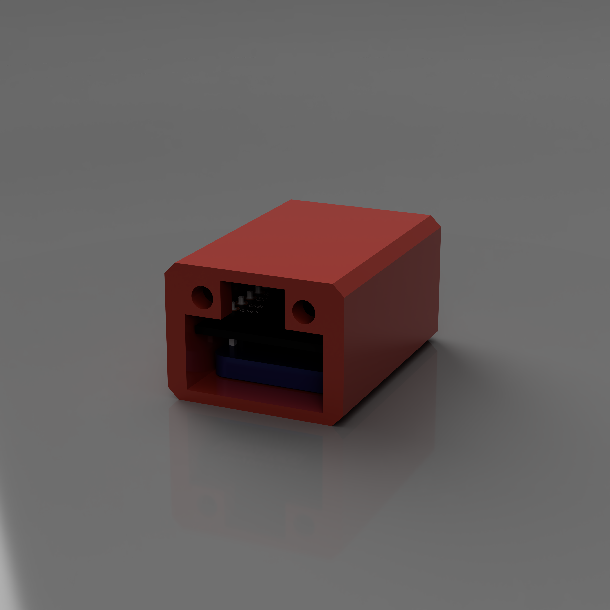
[picture p14: Documentation/Milestone 3/graphics/cad/wearable_2.png]
  
  \captionsetup{width=0.8\linewidth, justification=centering}
  \centering
  \captionof{figure}{Assembled wearable device}
  \label{fig:wearable_2}
\end{minipage}%
\begin{minipage}{.5\textwidth}
  \centering
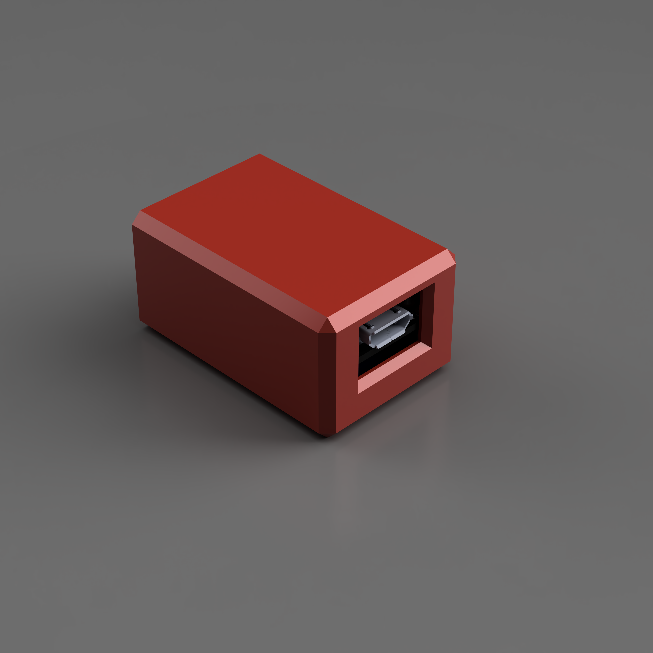
[picture p15: Documentation/Milestone 3/graphics/cad/wearable_1.PNG]
  
  \captionsetup{width=0.8\linewidth, justification=centering}
  \centering
  \captionof{figure}{Assembled wearable device}
  \label{fig:wearable_1}
\end{minipage}
\end{figure}
