SeanCoaker/Masters-Group-Project/Documentation/Milestone 3/graphics/cad/wearable_clip_0.tex

\begin{figure}[H]
\centering
\begin{minipage}{.5\textwidth}
  \centering
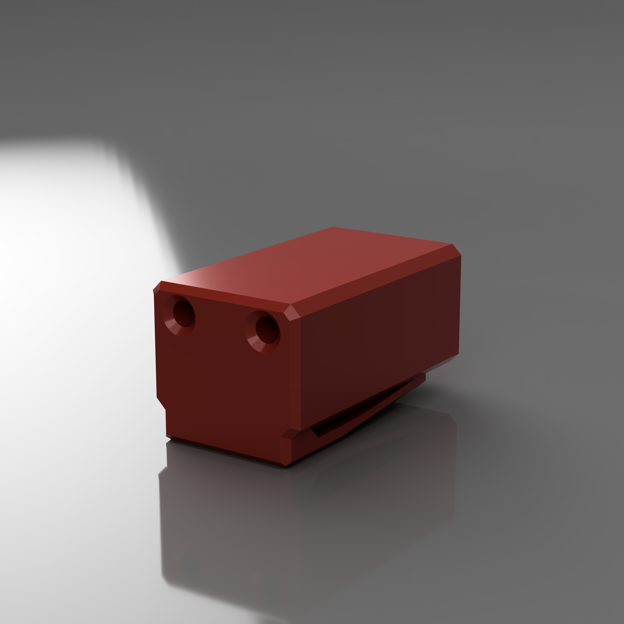
[picture p16: Documentation/Milestone 3/graphics/cad/wearable_clip_1.png]
  
  \captionsetup{width=0.8\linewidth, justification=centering}
  \centering
  \captionof{figure}{Wearable device with clip attachment}
  \label{fig:wearable_clip_1}
\end{minipage}%
\begin{minipage}{.5\textwidth}
  \centering
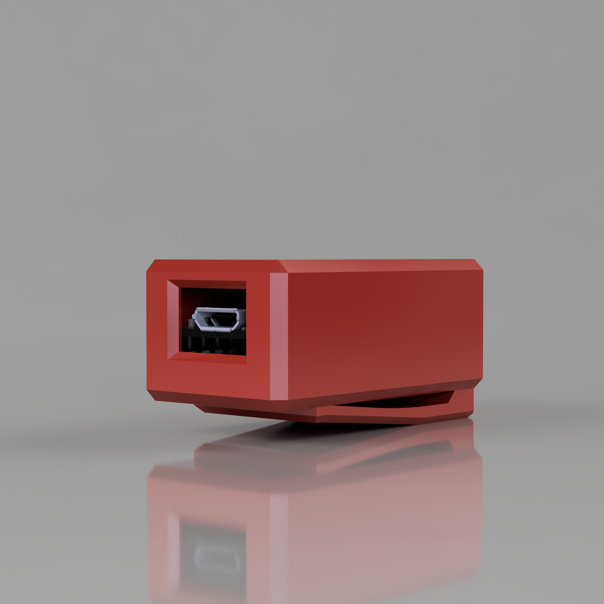
[picture p17: Documentation/Milestone 3/graphics/cad/wearable_clip_2.png]
  
  \captionsetup{width=0.8\linewidth, justification=centering}
  \centering
  \captionof{figure}{Wearable device with clip attachment}
  \label{fig:wearable_clip_2}
\end{minipage}
\end{figure}
