SeanCoaker/Masters-Group-Project/Documentation/Milestone 3/graphics/cad/wearable_strap_0.tex

\begin{figure}[H]
\centering
\begin{minipage}{.5\textwidth}
  \centering
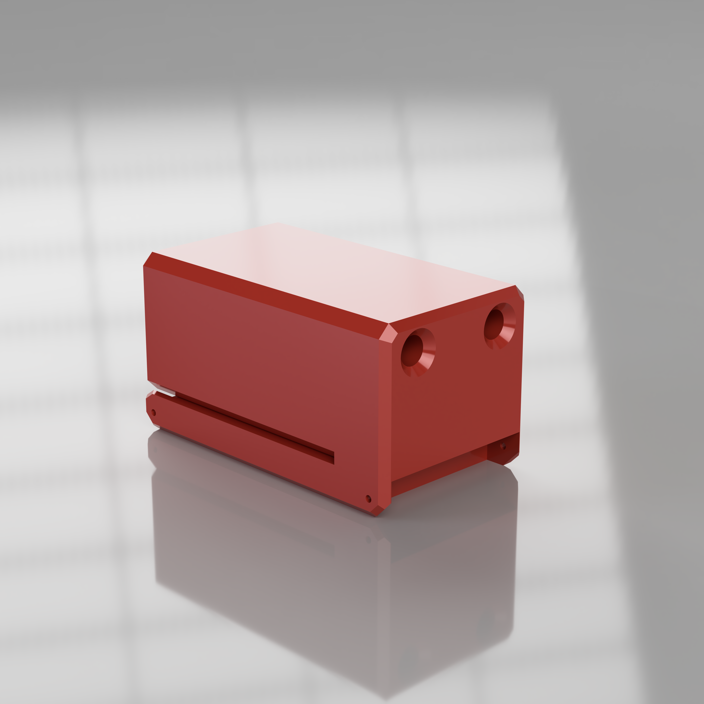
[picture p18: Documentation/Milestone 3/graphics/cad/wearable_strap_1.PNG]
  
  \captionsetup{width=0.8\linewidth, justification=centering}
  \centering
  \captionof{figure}{Wearable device with strap attachment}
  \label{fig:wearable_strap_1}
\end{minipage}%
\begin{minipage}{.5\textwidth}
  \centering
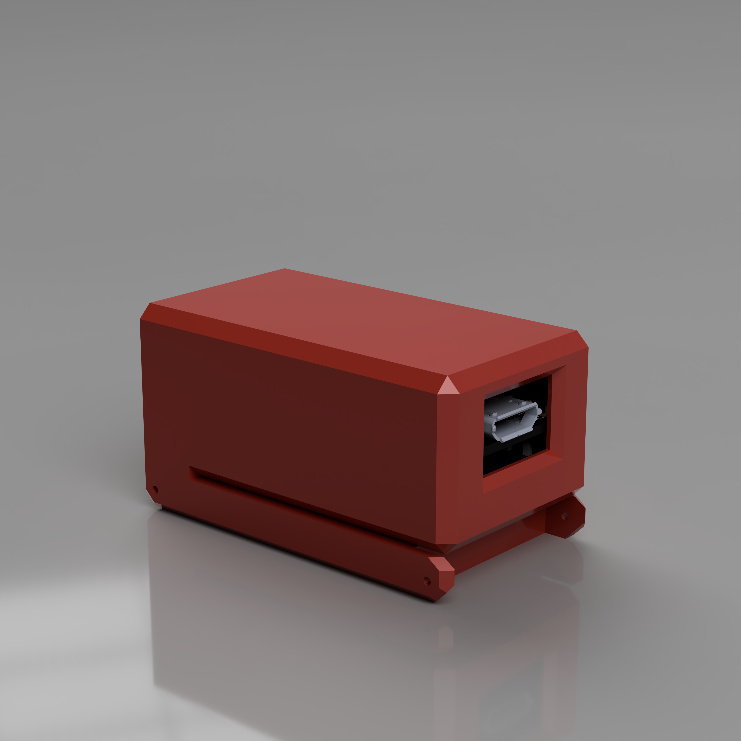
[picture p19: Documentation/Milestone 3/graphics/cad/wearable_strap_2.PNG]
  
  \captionsetup{width=0.8\linewidth, justification=centering}
  \centering
  \captionof{figure}{Wearable device with strap attachment}
  \label{fig:wearable_strap_2}
\end{minipage}
\end{figure}
