SeanCoaker/Masters-Group-Project/Presentations/first_presentation_final.pdf

First Presentation

## First Presentation

Bangor Health Clinic Group

Swansea University

November 22, 2021

Bangor Health Clinic Group | Swansea University | November 22, 2021 | 1 / 5

## Initial Meeting with Client

Thursday 18th November.
Clarified and expanded project brief.

Discussed potential budget.
Identified 2 possible paths for final implementation.

Discussed possible stretch targets.

Bangor Health Clinic Group | Swansea University | November 22, 2021 | 2 / 5

## The Two Options

A wearable device
A non-wearable device
Bangor Health Clinic Group | Swansea University | November 22, 2021 | 3 / 5

## The Two Options

A wearable device
A non-wearable device

Wearable Device

Likely a watch that will include an accelerometer. The watch will detect when the patient is moving and should the second device on the walking aid not detect movement, a calming voice (family member) will remind the patient to use their walking aid. Downsides include needing to keep 2 devices charged, and patients/users disliking wearable devices. Upsides include allowing for the largest feature set.

## The Two Options

A wearable device
A non-wearable device

Non-Wearable Device

Likely a pressure pad that detects when the patient is no longer sitting/lying on the pad. Should the second device on the walking aid not detect movement within a time period of pressure not being detected on the pad, a calming voice (family member) will remind the patient to use their walking aid. Downsides include not being as portable, and likely confined to one location at once. Upsides include only needed to charge one device, ease of implementation and ease of integration into users lives.

## Hardware Choices

Arduino.
TinyPICO devices using ESP32 chips (18mm x 32mm).

Accelerometers for wearables, pressure pads for non-wearables.

3D Printed protoypes.

Bangor Health Clinic Group | Swansea University | November 22, 2021 | 4 / 5

## Next Steps

Meet with client again to finalise user requirements.

Begin developing milestone 1 document.
Procure hardware needed to develop the project using available funding.
Bangor Health Clinic Group | Swansea University | November 22, 2021 | 5 / 5
