SeanCoaker/Masters-Group-Project/Presentations/presentation1.pdf

First Presentation

## First Presentation

Bangor Health Clinic Group

Swansea University

November 21, 2021

Bangor Health Clinic Group | Swansea University | November 21, 2021 | 1 / 5

## Initial Meeting

Thursday 18th November.
Fleshed out project brief.

Discussed potential budget.
Came out with 2 options for the final product.
Bangor Health Clinic Group | Swansea University | November 21, 2021 | 2 / 5

## The 2 Options

A wearable device
A non-wearable device
Bangor Health Clinic Group | Swansea University | November 21, 2021 | 3 / 5

## The 2 Options

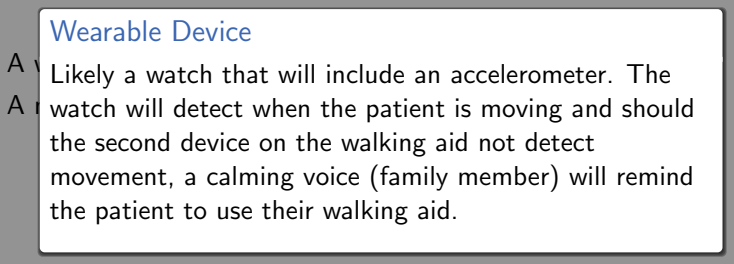
[picture p22: figure]
A wearable device; A non-wearable device; Wearable Device; the patient to use their walking aid.

Likely a watch that will include an accelerometer. The watch will detect when the patient is moving and should the second device on the walking aid not detect movement, a calming voice (family member) will remind

## The 2 Options

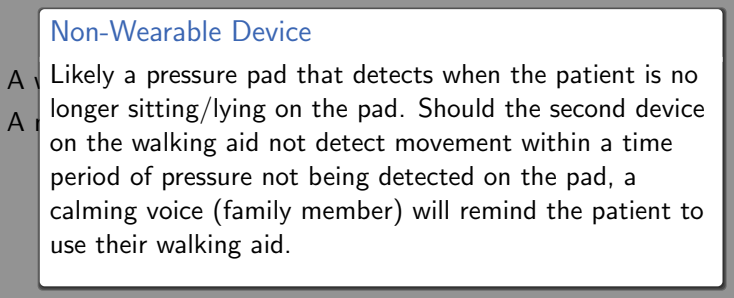
[picture p23: figure]
A wearable device; A non-wearable device; Non-Wearable Device; use their walking aid.

Likely a pressure pad that detects when the patient is no longer sitting/lying on the pad. Should the second device on the walking aid not detect movement within a time period of pressure not being detected on the pad, a calming voice (family member) will remind the patient to

## Hardware Choices

Arduino.
TinyPICO devices using ESP32 chips (18mm x 32mm). Accelerometers with pressure pads (maybe).

Potentially a 3D printer for prototyping the devices.

Bangor Health Clinic Group | Swansea University | November 21, 2021 | 4 / 5

## Next Steps

Meet with client again to finalise user requirements.

Begin developing milestone 1 document.
Procure hardware needed to develop the project.
Bangor Health Clinic Group | Swansea University | November 21, 2021 | 5 / 5
