SeanCoaker/Masters-Group-Project/Documentation/Milestone 3/graphics/ganttm2-2.tex

% [H] means put the figure HERE, directly when you input this code.
\begin{figure}[H]
	\centering
	\captionsetup{width=1.0\linewidth}

% We set the width of the figure based on the width of one line of text on the page.
% The value can be tuned to any value in [0.0, 1.0] to scale the image while maintaining its aspect ratio.

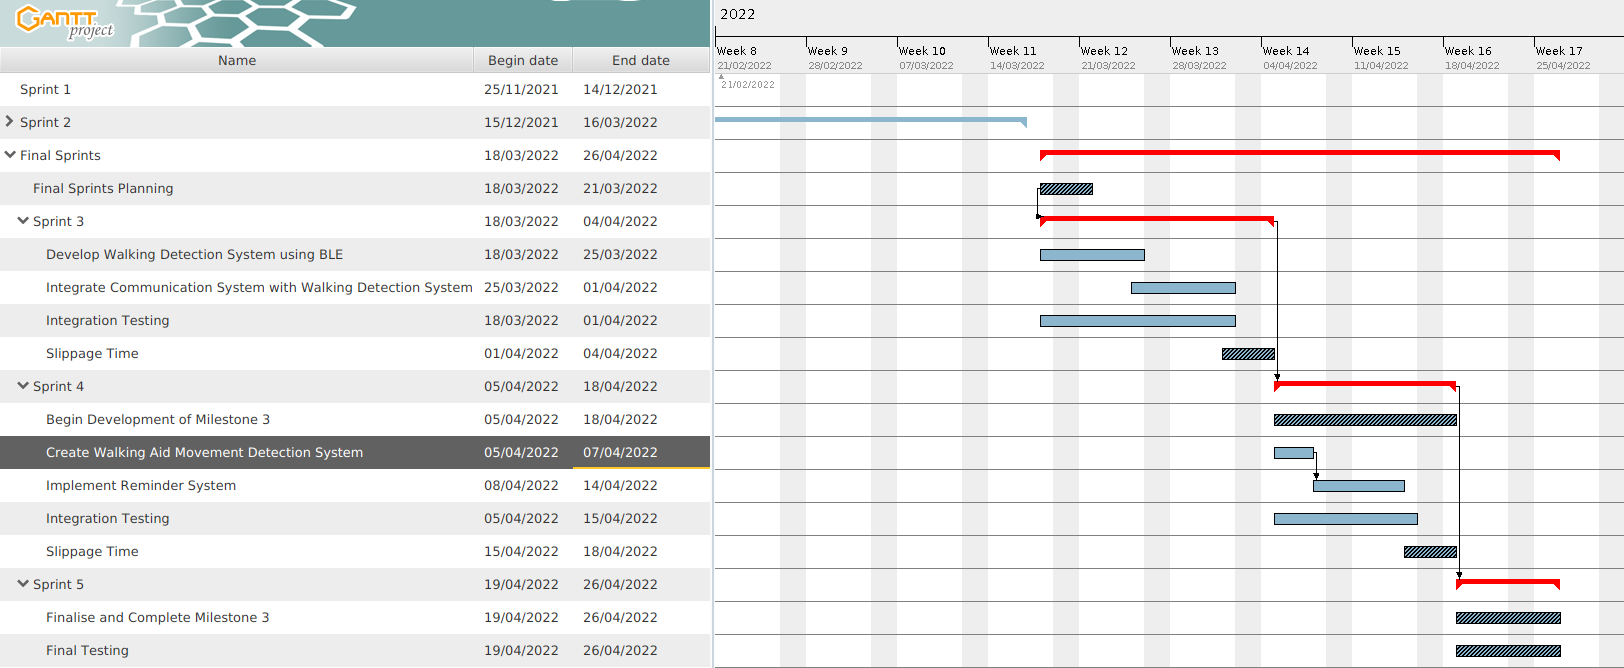
[picture p26: Documentation/Milestone 3/graphics/ganttm2.png]
	

% Caption is defined with a short and long version. The short version is shown in the
% List of Figures section, and the long version is used directly with the figure.
	\caption[Milestone 2 Gantt Chart]{Our updated Gantt chart schedule from Milestone 2 \cite{mile2}}

% For figures label should be defined after the caption to ensure proper figure numbering.
	\label{fig:ganttm2-2}

\end{figure}
