SeanCoaker/Masters-Group-Project/Documentation/Milestone 3/graphics/walking_aid_uml.tex

% [H] means put the figure HERE, directly when you input this code.
\begin{figure}[ht!]
	\centering
	\captionsetup{width=1.0\linewidth}

% We set the width of the figure based on the width of one line of text on the page.
% The value can be tuned to any value in [0.0, 1.0] to scale the image while maintaining its aspect ratio.

	

% Caption is defined with a short and long version. The short version is shown in the
% List of Figures section, and the long version is used directly with the figure.
	\caption[Walking Aid Device Class Diagram]{A class diagram for the walking aid device software system illustrating how the classes interact with each other.}

% For figures label should be defined after the caption to ensure proper figure numbering.
	\label{fig:class_diagram_walking_aid}

\end{figure}
