SeanCoaker/Masters-Group-Project/Documentation/Milestone 2/figures/end-housing.png

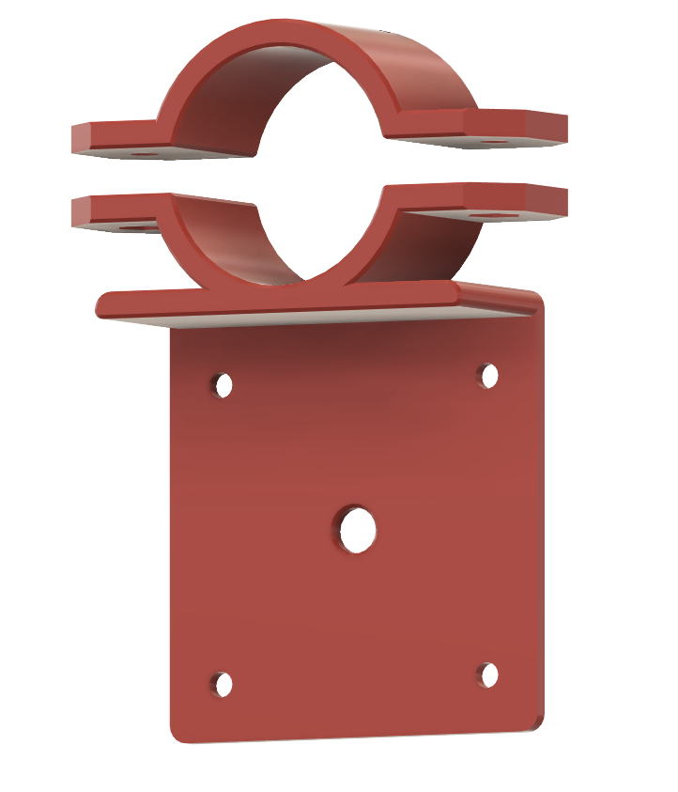
Documentation/Milestone 2/figures/end-housing.png
