SeanCoaker/Masters-Group-Project/Documentation/Milestone 2/figures/front-housing.png

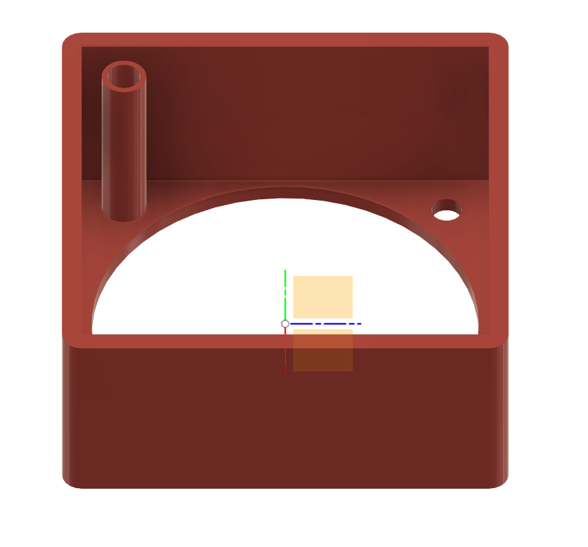
Documentation/Milestone 2/figures/front-housing.png
