SeanCoaker/Masters-Group-Project/Documentation/Milestone 2/figures/mid-housing.png

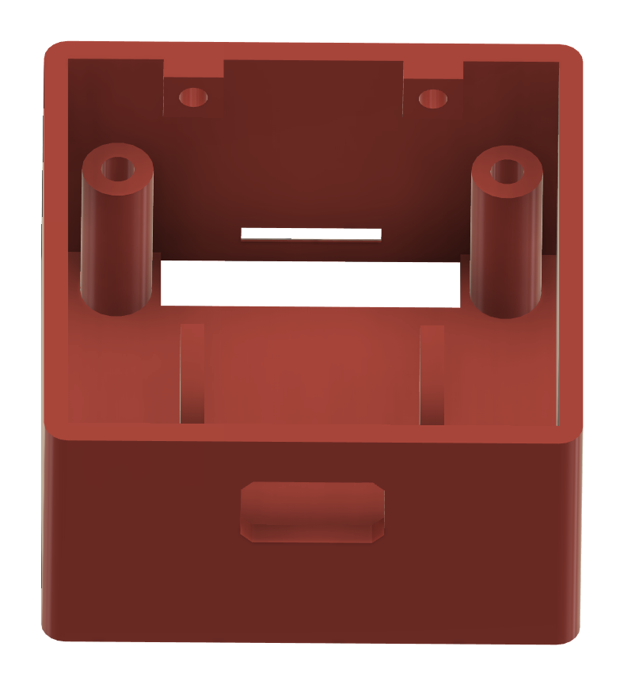
Documentation/Milestone 2/figures/mid-housing.png
