SeanCoaker/Masters-Group-Project/Documentation/Milestone 2/figures/Milestone2_Gantt_Chart.jpg

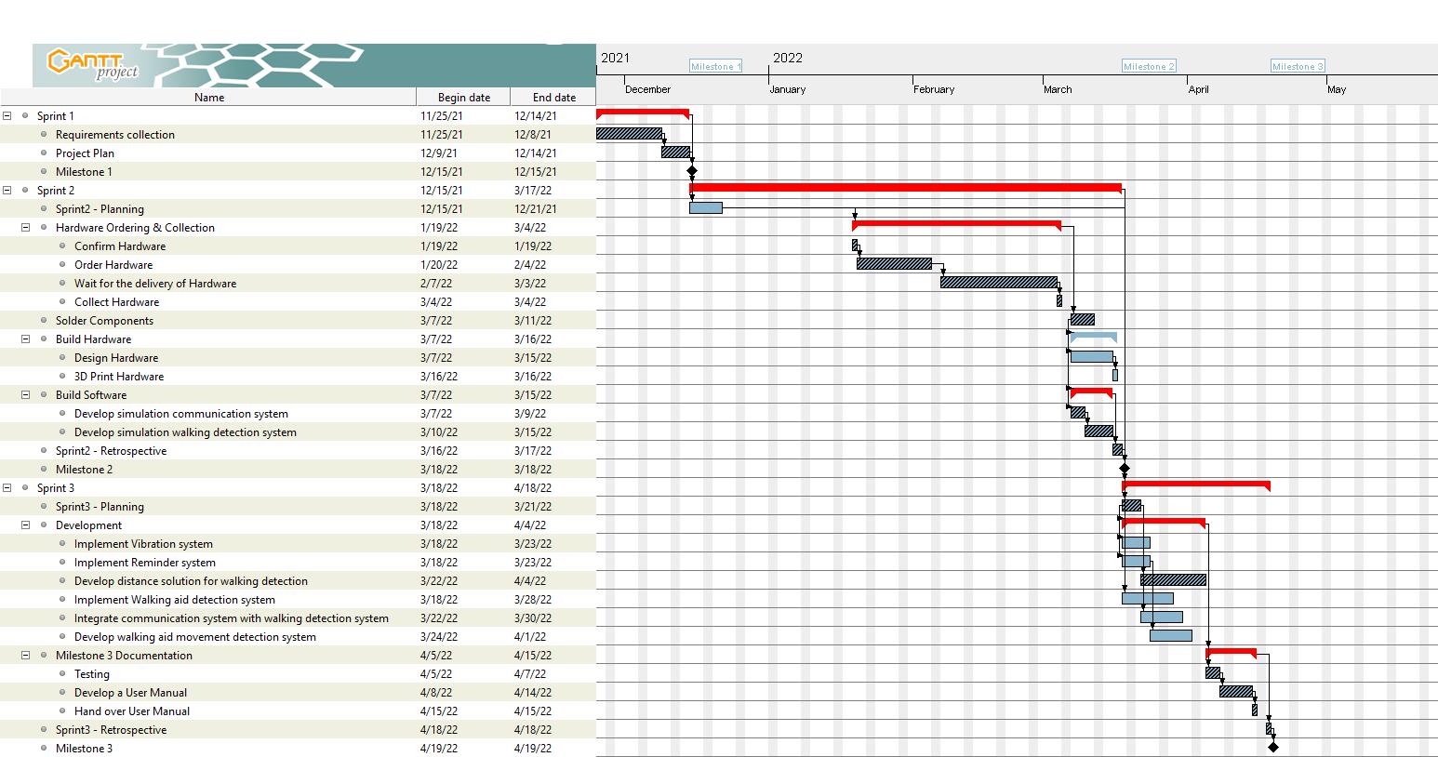
Documentation/Milestone 2/figures/Milestone2_Gantt_Chart.jpg
