SeanCoaker/Masters-Group-Project/Documentation/Milestone 3/BangorGroupM3/poster.png

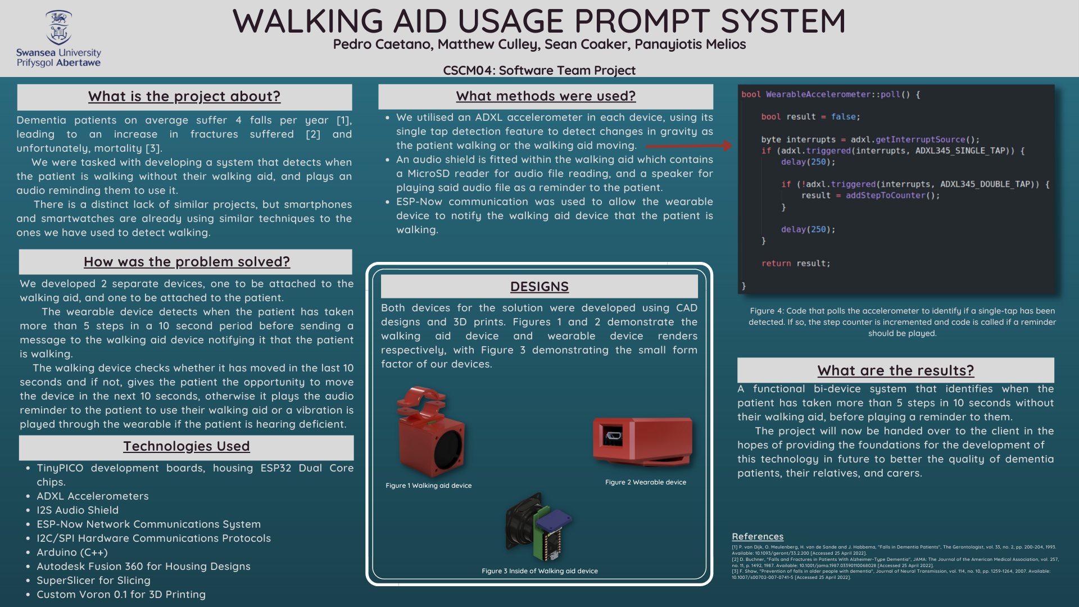
Documentation/Milestone 3/BangorGroupM3/poster.png
