SeanCoaker/Masters-Group-Project/Documentation/Milestone 3/graphics/cad/walkingaid_1.png

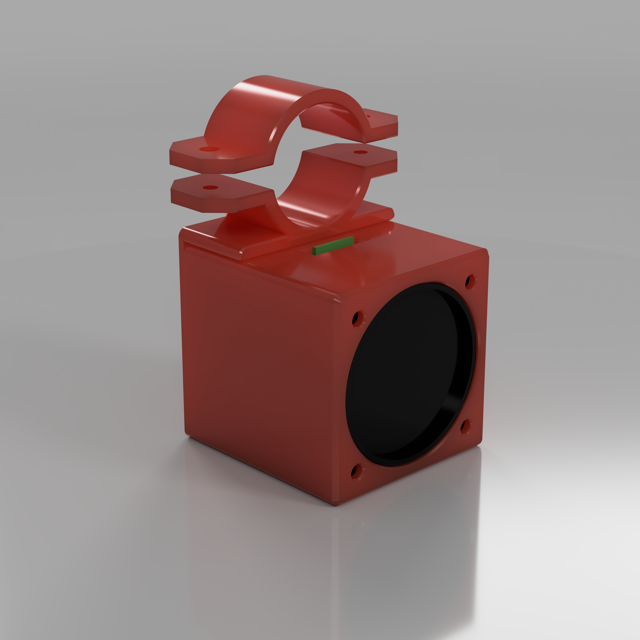
Documentation/Milestone 3/graphics/cad/walkingaid_1.png
