SeanCoaker/Masters-Group-Project/Documentation/Milestone 3/graphics/speaker.png

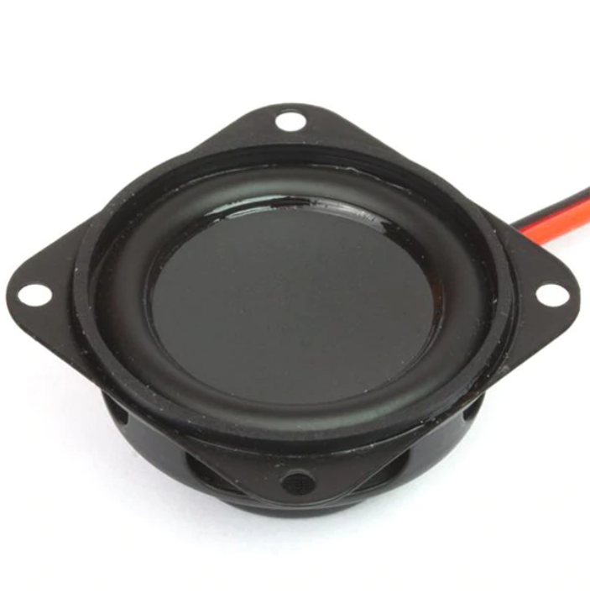
Documentation/Milestone 3/graphics/speaker.png
