SeanCoaker/Masters-Group-Project/Documentation/Milestone 3/UML/WalkingAidDevice/activity diagram.png

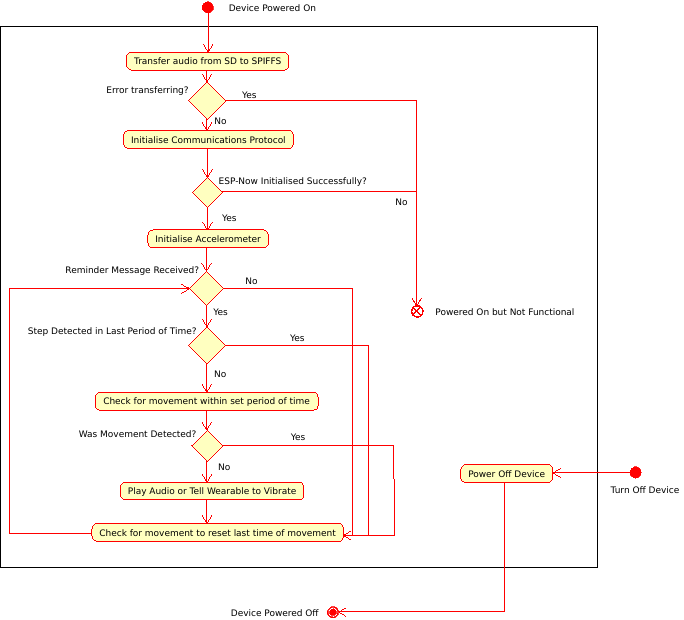
Documentation/Milestone 3/UML/WalkingAidDevice/activity diagram.png
