SeanCoaker/Masters-Group-Project/Documentation/Milestone 3/UML/WalkingAidDevice/class diagram.png

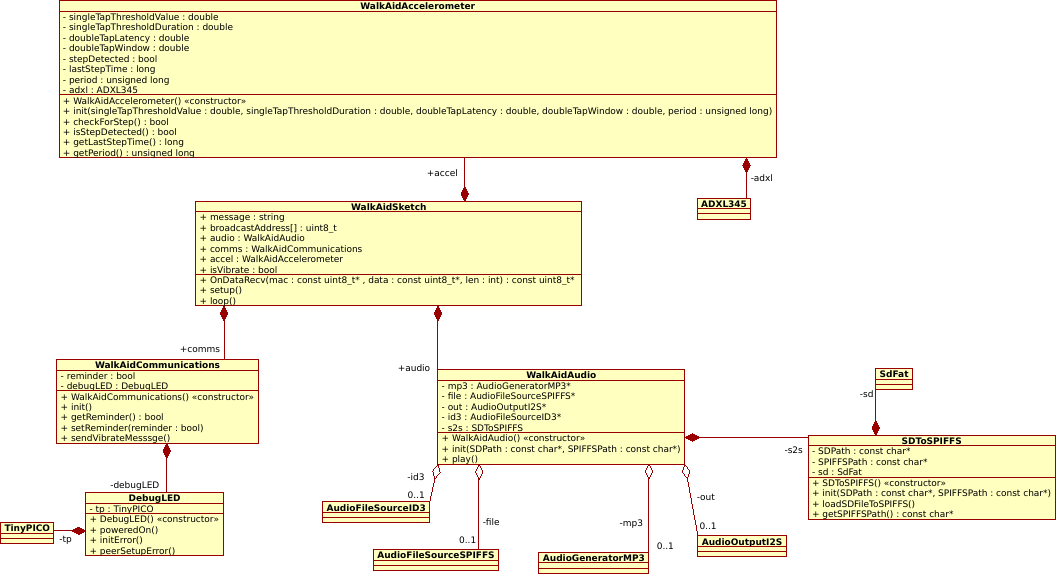
Documentation/Milestone 3/UML/WalkingAidDevice/class diagram.png
