SeanCoaker/Masters-Group-Project/Documentation/Milestone 3/UML/WearableDevice/activity diagram.png

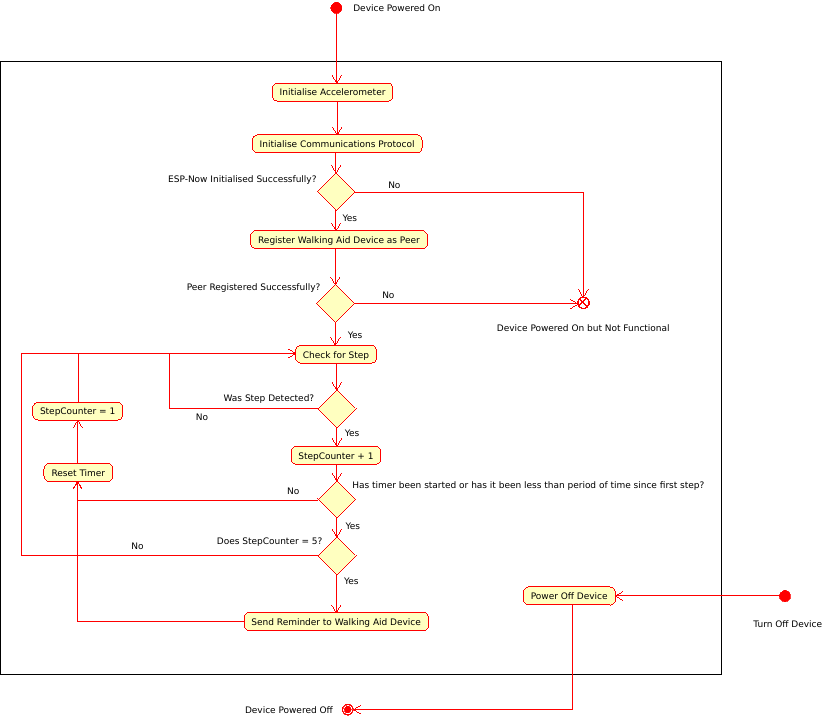
Documentation/Milestone 3/UML/WearableDevice/activity diagram.png
