SeanCoaker/Masters-Group-Project/Documentation/Milestone 3/UML/WearableDevice/class diagram.png

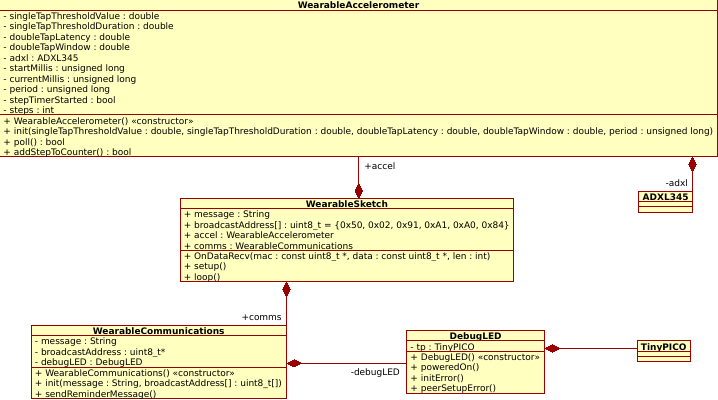
Documentation/Milestone 3/UML/WearableDevice/class diagram.png
