SeanCoaker/Masters-Group-Project/Documentation/Milestone 3/graphics/cad/components_0.tex

\begin{figure}[H]
\centering
\begin{minipage}{.5\textwidth}
  \centering
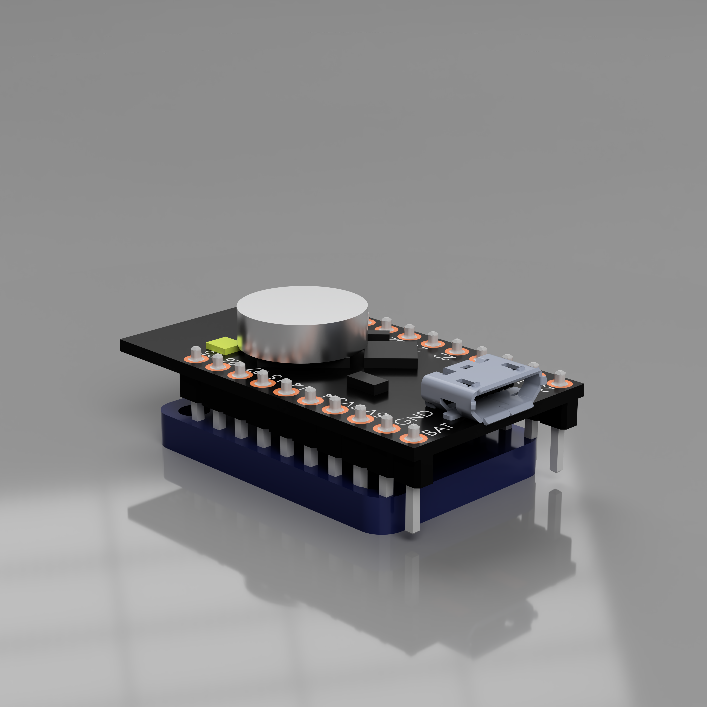
[picture p41: Documentation/Milestone 3/graphics/cad/wearable_components_1.png]
  
  \captionsetup{width=0.8\linewidth, justification=centering}
  \centering
  \captionof{figure}{Wearable device component layout}
  \label{fig:wearable_components_1}
\end{minipage}%
\begin{minipage}{.5\textwidth}
  \centering
  
  \captionsetup{width=0.8\linewidth, justification=centering}
  \centering
  \captionof{figure}{Walking aid device component layout}
  \label{fig:walking_components_1}
\end{minipage}
\end{figure}
