SeanCoaker/Masters-Group-Project/Documentation/Milestone 3/graphics/cad/wearable_components_1.tex

\begin{figure}[H]
\centering
\begin{minipage}{.5\textwidth}
  \centering
  
  \captionsetup{width=0.8\linewidth, justification=centering}
  \centering
  \captionof{figure}{Wearable device component layout}
  \label{fig:wearable_components_1}
\end{minipage}%
\begin{minipage}{.5\textwidth}
  \centering
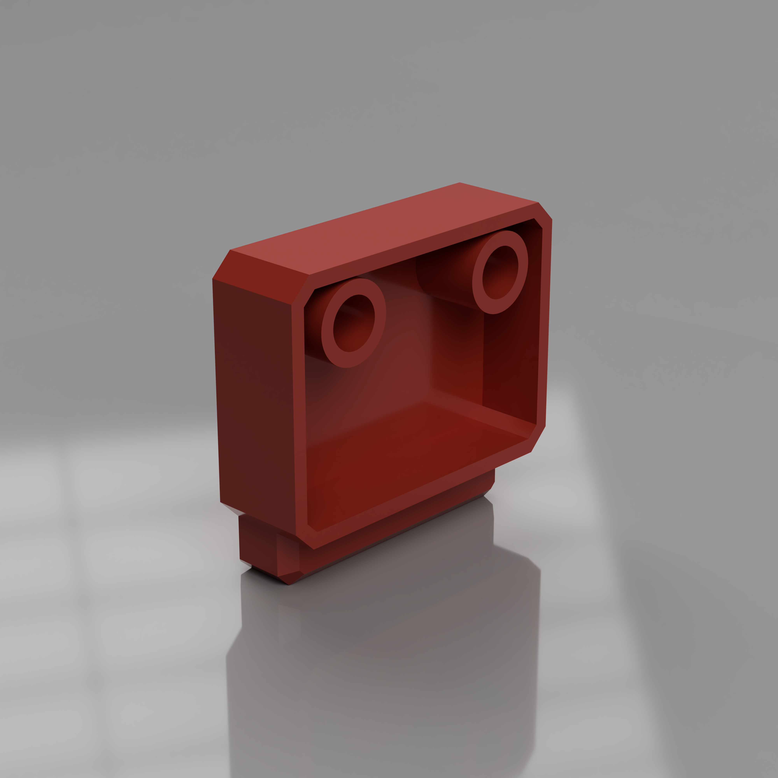
[picture p42: Documentation/Milestone 3/graphics/cad/wearable_endcase_1.png]
  
  \captionsetup{width=0.8\linewidth, justification=centering}
  \centering
  \captionof{figure}{Walking aid modular end casing}
  \label{fig:walkingaid_endcase_1}
\end{minipage}
\end{figure}
