SeanCoaker/Masters-Group-Project/Documentation/Milestone 3/chapter/testing/walking aid/walking_aid_BOOT02.tex

{
\bgroup
\def\arraystretch{1.5}
\centering
\begin{table}[H]
\begin{tabular}{| m{0.97\textwidth} |} 
    \hline
    \textbf{Test Case:} TEST\_WALKING\_AID\_BOOT02\\ 
    \hline
    \textbf{Assert Specification(s):} The walking aid device should clearly notify surrounding users that it has been powered on.\\ 
    \hline
    \textbf{Description:} Partially following the tangible bits model, this test ensures that the walking aid device flashes its LED on boot to represent the device entering the foreground from the background and powering on.\\ 
    \hline
    \textbf{Acceptance Criteria:} 
        \begin{itemize}
            \item On boot, the LED of the walking aid device should flash green for 1 second to represent the device being powered on.
        \end{itemize}\\ 
    \hline
    \textbf{Result:} \colorbox{green}{PASS}\\ 
    \hline
\end{tabular}
\caption{Walking Aid Device Boot Test Case 2}
\end{table}
\egroup
}
