SeanCoaker/Masters-Group-Project/Documentation/Milestone 3/chapter/testing/walking aid/walking_aid_COMMS02.tex

{
\bgroup
\def\arraystretch{1.5}
\centering
\begin{table}[H]
\begin{tabular}{| m{0.97\textwidth} |} 
    \hline
    \textbf{Test Case:} TEST\_WALKING\_AID\_COMMS02\\ 
    \hline
    \textbf{Assert Specification(s):} 
    
    \begin{itemize}
        \item FREQ1: The wearable device should detect when a patient has walked more than 1 metre before communicating with the walking aid.
        \item FREQ5: The wearable device should communicate to the
        walking aid device to let it know when it's started
        moving.
    \end{itemize}\\ 
    \hline
    \textbf{Description:} This test ensures that the walking aid device can accept messages from the wearable device.\\ 
    \hline
    \textbf{Acceptance Criteria:} 
        \begin{itemize}
            \item The walking aid device should detect the reminder message sent by the wearable device.
        \end{itemize}\\ 
    \hline
    \textbf{Result:} \colorbox{green}{PASS}\\ 
    \hline
\end{tabular}
\caption{Walking Aid Device Communications Test Case 2}
\end{table}
\egroup
}
