SeanCoaker/Masters-Group-Project/Documentation/Milestone 3/chapter/testing/walking aid/walking_aid_IMPCT01.tex

{
\bgroup
\def\arraystretch{1.5}
\centering
\begin{table}[H]
\begin{tabular}{| m{0.97\textwidth} |} 
    \hline
    \textbf{Test Case:} TEST\_WALKING\_AID\_IMPCT01\\ 
    \hline
    \textbf{Assert Specification(s):} The system should be able to be dropped from three feet (0.92m) onto hard flooring without suffering critical damage.\\ 
    \hline
    \textbf{Description:} This test ensures that the device would survive the walking aid being dropped, such as the walking stick its attached to being released.\\ 
    \hline
    \textbf{Acceptance Criteria:} 
        \begin{itemize}
            \item Device continues to work after the fall
            \item No excessive damage to enclosure or mount
        \end{itemize}\\ 
    \hline
    \textbf{Result:} \colorbox{green}{PASS}\\ 
    \hline
\end{tabular}
\caption{Walking Aid Device Impact Test Case 1}
\end{table}
\egroup
}
