SeanCoaker/Masters-Group-Project/Documentation/Milestone 3/chapter/testing/walking aid/walking_aid_INIT02.tex

{
\bgroup
\def\arraystretch{1.5}
\centering
\begin{table}[H]
\begin{tabular}{| m{0.97\textwidth} |} 
    \hline
    \textbf{Test Case:} TEST\_WALKING\_AID\_INIT02\\ 
    \hline
    \textbf{Assert Specification(s):} Should the walking aid device experience an issue when attempting to add the wearable device as an ESP-Now peer, a debugging LED light should be displayed to help the user understand the issue.\\ 
    \hline
    \textbf{Description:} This test ensures that the walking aid device displays a debugging LED when it experiences an issue in registering the wearable device as a peer for communication.\\ 
    \hline
    \textbf{Acceptance Criteria:} 
        \begin{itemize}
            \item The walking aid device should display a solid orange LED light when the wearable device cannot add the wearable device as a peer.
        \end{itemize}\\ 
    \hline
    \textbf{Result:} \colorbox{green}{PASS}\\ 
    \hline
\end{tabular}
\caption{Walking Aid Device Initialisation Test Case 2}
\end{table}
\egroup
}
