SeanCoaker/Masters-Group-Project/Documentation/Milestone 3/chapter/testing/walking aid/walking_aid_INIT05.tex

{
\bgroup
\def\arraystretch{1.5}
\centering
\begin{table}[H]
\begin{tabular}{| m{0.97\textwidth} |} 
    \hline
    \textbf{Test Case:} TEST\_WALKING\_AID\_INIT05\\ 
    \hline
    \textbf{Assert Specification(s):} The walking aid device should not take a considerable amount of time to boot and initialise.\\ 
    \hline
    \textbf{Description:} This test ensures that the walking aid device does not take a considerable amount of time in initalising the ESP-Now communication protocol.\\ 
    \hline
    \textbf{Acceptance Criteria:} 
        \begin{itemize}
            \item The walking aid device should take less than 5 seconds to inititialise the ESP-Now communication protocol.
        \end{itemize}\\ 
    \hline
    \textbf{Result:} \colorbox{green}{PASS}\\ 
    \hline
\end{tabular}
\caption{Walking Aid Device Initialisation Test Case 5}
\end{table}
\egroup
}
