SeanCoaker/Masters-Group-Project/Documentation/Milestone 3/chapter/testing/walking aid/walking_aid_REM01.tex

{
\bgroup
\def\arraystretch{1.5}
\centering
\begin{table}[H]
\begin{tabular}{| m{0.97\textwidth} |} 
    \hline
    \textbf{Test Case:} TEST\_WALKING\_AID\_REM01\\ 
    \hline
    \textbf{Assert Specification(s):} FREQ2: Patients should be alerted with the voice of a friend, carer or relative to avoid startling them.\\ 
    \hline
    \textbf{Description:} This test ensures that the walking aid device plays the audio file when a message has been received from the wearable device and the walking aid has not been moved.\\ 
    \hline
    \textbf{Acceptance Criteria:} 
        \begin{itemize}
            \item The walking aid device should play the audio file when a message is received from the wearable device and the walking aid has not met the criteria for being moved.
        \end{itemize}\\ 
    \hline
    \textbf{Result:} \colorbox{green}{PASS}\\ 
    \hline
\end{tabular}
\caption{Walking Aid Device Reminder Test Case 1}
\end{table}
\egroup
}
