SeanCoaker/Masters-Group-Project/Documentation/Milestone 3/chapter/testing/walking aid/walking_aid_WALK01.tex

{
\bgroup
\def\arraystretch{1.5}
\centering
\begin{table}[H]
\begin{tabular}{| m{0.97\textwidth} |} 
    \hline
    \textbf{Test Case:} TEST\_WALKING\_AID\_WALK01\\ 
    \hline
    \textbf{Assert Specification(s):} A reminder should be sent to the user when they start moving without their walking aid.\\ 
    \hline
    \textbf{Description:} This test ensures that the walking aid device is able to detect that it is moving due to single tap detection in the accelerometer.\\ 
    \hline
    \textbf{Acceptance Criteria:} 
        \begin{itemize}
            \item The walking aid device should detect when it is being lifted and placed on the ground by the user.
        \end{itemize}\\ 
    \hline
    \textbf{Result:} \colorbox{green}{PASS}\\ 
    \hline
\end{tabular}
\caption{Walking Aid Device Movement Detection Test Case 1}
\end{table}
\egroup
}
