SeanCoaker/Masters-Group-Project/Documentation/Milestone 3/chapter/testing/walking aid/walking_aid_WALK03.tex

{
\bgroup
\def\arraystretch{1.5}
\centering
\begin{table}[H]
\begin{tabular}{| m{0.97\textwidth} |} 
    \hline
    \textbf{Test Case:} TEST\_WALKING\_AID\_WALK03\\ 
    \hline
    \textbf{Assert Specification(s):} The system should allow the user enough time to get to their walking aid device before a reminder is played.\\ 
    \hline
    \textbf{Description:} This test ensures that the user is offered time to use the walking aid after their walking has been detected, before playing the reminder.\\ 
    \hline
    \textbf{Acceptance Criteria:} 
        \begin{itemize}
            \item Movement detected within 10 seconds after a message has been sent by the wearable device should stop the reminder from being played.
        \end{itemize}\\ 
    \hline
    \textbf{Result:} \colorbox{green}{PASS}\\ 
    \hline
\end{tabular}
\caption{Walking Aid Device Movement Detection Test Case 3}
\end{table}
\egroup
}
