SeanCoaker/Masters-Group-Project/Documentation/Milestone 3/chapter/testing/wearable/wearable_IMPCT01.tex

{
\bgroup
\def\arraystretch{1.5}
\centering
\begin{table}[H]
\begin{tabular}{| m{0.97\textwidth} |} 
    \hline
    \textbf{Test Case:} TEST\_WEARABLE\_IMPCT01\\ 
    \hline
    \textbf{Assert Specification(s):} The system should be able to be fallen onto from three feet (0.92m) whilst on hard flooring without suffering critical damage. The weight falling should be 100kg\\ 
    \hline
    \textbf{Description:} This test ensures that the device would survive a patient falling whilst the device is on their person.\\ 
    \hline
    \textbf{Acceptance Criteria:} 
        \begin{itemize}
            \item Device continues to work after the fall
            \item No excessive damage to enclosure or mount
        \end{itemize}\\ 
    \hline
    \textbf{Result:} \colorbox{green}{PASS}\\ 
    \hline
\end{tabular}
\caption{Wearable Device Impact Test Case 1}
\end{table}
\egroup
}
