SeanCoaker/Masters-Group-Project/Documentation/Milestone 3/chapter/testing/wearable/wearable_INIT01.tex

{
\bgroup
\def\arraystretch{1.5}
\centering
\begin{table}[H]
\begin{tabular}{| m{0.97\textwidth} |} 
    \hline
    \textbf{Test Case:} TEST\_WEARABLE\_INIT01\\ 
    \hline
    \textbf{Assert Specification(s):} The wearable device should handle errors safely and ensure that the user can identify the issue with the device.\\ 
    \hline
    \textbf{Description:} This test ensures that the wearable device displays a debugging LED when it experiences a failure in initialising ESP-Now.\\ 
    \hline
    \textbf{Acceptance Criteria:} 
        \begin{itemize}
            \item The wearable device should display a solid red LED light when it cannot initialise ESP-Now successfully.
        \end{itemize}\\ 
    \hline
    \textbf{Result:} \colorbox{green}{PASS}\\ 
    \hline
\end{tabular}
\caption{Wearable Device Initialisation Test Case 1}
\end{table}
\egroup
}
