SeanCoaker/Masters-Group-Project/Documentation/Milestone 3/chapter/testing/wearable/wearable_REM01.tex

{
\bgroup
\def\arraystretch{1.5}
\centering
\begin{table}[H]
\begin{tabular}{| m{0.97\textwidth} |} 
    \hline
    \textbf{Test Case:} TEST\_WEARABLE\_REM01\\ 
    \hline
    \textbf{Assert Specification(s):} FREQ3: The wearable device should include a solution for deaf people that still reminds them to take their walking aid with them without the need for an audio alarm.\\ 
    \hline
    \textbf{Description:} This test ensures that the wearable device vibrates when prompted to by the walking aid device.\\ 
    \hline
    \textbf{Acceptance Criteria:} 
        \begin{itemize}
            \item The wearable device should vibrate when a message has been received from the walking aid device.
        \end{itemize}\\ 
    \hline
    \textbf{Result:} \colorbox{green}{PASS}\\ 
    \hline
\end{tabular}
\caption{Wearable Device Reminder Test Case 1}
\end{table}
\egroup
}
