SeanCoaker/Masters-Group-Project/Documentation/Milestone 1/chapter/risks.tex

\chapter{Risk Analysis} \label{ch:risk}

    Within this section, we have included a risk analysis of the proposed project by providing a list of possible risks
    that could negatively affect it.\ We will provide a list of these risks along with mitigation strategies that we will
    use to avoid the occurrence of said risks.\ Upon completion of the risk analysis, we will include a matrix
    demonstrating the likelihood of a risk occurring and the impact that risk could have on the project should it occur.

	\section{Risk Identification and Mitigation Strategies}

    	\vspace{3em} \input{./tables/risk_table.tex} \vspace{6em}

	\section{Risk Likelihood and Impact Matrix}

		\vspace{3em} \input{./tables/risk_matrix.tex}
