SeanCoaker/Masters-Group-Project/Documentation/Milestone 1/tables/risk_matrix.tex

\small
\begin{xltabular}[H]{\textwidth}{X | X | X | X}
    \caption[Risk likelihhood/impact matrix]{A matrix detailing the likelihood of a risk occurring along with the relative impact caused by that risk occurring.}\\

    \toprule

    \diagbox[innerwidth=3.2cm]{Likelihood}{Impact} & Low & Medium & High\\

    \midrule
    \endfirsthead

    \toprule

    \diagbox[innerwidth=3.2cm]{Likelihood}{Impact} & Low & Medium & High\\

    \midrule
    \endhead

    \hline
    \multicolumn{4}{|r|}{{Continued on next page}}\\
    \hline
    \endfoot

    \bottomrule
    \endlastfoot

    Low

    &

    &

    RSK2, RSK4, RSK7

    &

    RSK8, RSK13, RSK14\\

    \midrule

    Medium

    &

    RSK12

    &

    RSK3

    &

    RSK1, RSK5, RSK10, RSK11\\

    \midrule

    High

    &

    &

    RSK9

    &

    RSK6\\

\end{xltabular}
\label{tbl:risk_matrix}
