SeanCoaker/Masters-Group-Project/(threads)

Thread 11 (2022-03-08):

Finish Progress Since Milestone 1 Section

SeanCoaker, 2022-03-08:
- Add discussion on work carried out for comms between TinyPICOs, including discussion on using ESP NOW and comparison between ESP NOW, BLE and UWB.
- Detail code development towards walking detection, including code for acceleration change detection and single tap detection. Also compare accelerometer walking detection vs BLE distance walking detection.
- Discuss work done in terms of soldering and wiring devices ready for coding.
- Detail research carried out for walking detection, including flowcharts viewed for step counter.

Closed 2022-03-16.
