SeanCoaker/Masters-Group-Project/Documentation/Milestone 2/code/send_comms.ino

#include <esp_now.h>
#include <WiFi.h>

// MAC Address to send data to
uint8_t broadcastAddress[] = {0x50, 0x02, 0x91, 0xA1, 0xA9, 0x0C};

// Message to send
String message = "Test";

// Callback when data is sent
void OnDataSent(const uint8_t *mac_addr, esp_now_send_status_t status) {
  Serial.print("\r\nLast Packet Send Status: ");
  Serial.println(status == ESP_NOW_SEND_SUCCESS ? "Delivery Success" : "Delivery Fail");
}
 
void setup() {
  // Initialise Serial Monitor for monitoring outputs
  Serial.begin(115200);
 
  // Set device as a Wi-Fi Station
  WiFi.mode(WIFI_STA);
  Serial.println(WiFi.macAddress());

  // Initialise ESP-NOW
  if (esp_now_init() != ESP_OK) {
    Serial.println("Error initializing ESP-NOW");
    return;
  }

  // Registers a callback function to use when callback is called.
  esp_now_register_send_cb(OnDataSent);
  
  // Register peer and set its details
  esp_now_peer_info_t peerInfo;
  memset(&peerInfo, 0, sizeof(peerInfo));
  memcpy(peerInfo.peer_addr, broadcastAddress, 6);
  peerInfo.channel = 0;  
  peerInfo.encrypt = false;
  
  // Add peer        
  if (esp_now_add_peer(&peerInfo) != ESP_OK){
    Serial.println("Failed to add peer");
    return;
  }
}
 
void loop() {

  // Send message via ESP-NOW
  esp_err_t result = esp_now_send(broadcastAddress, (uint8_t *) &message, sizeof(message));
   
  if (result == ESP_OK) {
    Serial.println("Message sent successfully");
  } else {
    Serial.println("Error sending the message");
  }

  delay(5000);
}
