SeanCoaker/Masters-Group-Project/(commit log)

2021-12-05 Added content to 'The problem' and 'current work' sections
2021-12-06 Added content to current work and similar work sections
2022-03-06 Added step counter feature for ADXL345
    - Added directory that stores code to identify that ADXL345 is working
    correctly.
    - Added accelStepCounter directory that includes a sketch that utlises
    changes in acceleration to increment step counter. Can be used in a
    wrist/ankle device.
    - Added tapStepCounter directory that uses ADXL345's built-in tap
    detection system to increment steps. Can be used in an ankle device.
    [accelStepCounter.ino, accelTest.ino, tapStepCounter.ino]
2022-03-08 Begun development of Milestone 2
    - Completed introduction section of milestone 2.
    - Began developing current progress section, including discussion on
    progress made prior to milestone 1.
    - Reorgranised file structure within the repository for easy viewing.
2022-03-10 Added description of work done for comms between TinyPICOs.
    - Added listing of code used to receive messages on walking aid device.
    - Described what the receive sketch does.
    - Added listing of code used to send messages to the walking aid device
    from the wearable device.
    - Described what the send sketch does.
2022-03-10 Added code that flashes LED when steps reach threshold.
    - The system works as follows:
    - When the first step is detected a timer is started.
    - Every step that is detected, a check is run to see if they are
    within 10 secs of the timer starting.
    - If they are within 10 seconds and the step counter reaches 5, a
    reminder is called.
    - If they are within 10 seconds and the step counter is less than 5,
    step counter increments.
    - If they are outside the 10 seconds, the timer and step counter is
    restarted.
    - Step counter threshold is 5 based on 1 step averaging 0.3 metres,
    allowing for some leeway over 1 metre of walking, as client wanted.
    - Reminder cur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
2022-03-13 Added text to begin discussion of walking detection system.
    - Mentioned solutions that we could implement with either BLE or
    accelerometer.
    - Mentioned the downfalls to each one.
2022-03-15 Progressed M2 and one of the step counter implementations
    - Added more details on work carried out for both step counter systems
    developed using accelerometers.
    - Converted I2C implementation of acceleration change step counter to
    SPI version.
2022-03-15 Completed progress since milestone 2 section, except CAD stuff.
    - Finished discussion on work I've done for step-counter system.
    - Included section on what we plan to do for future work and how it will
    benefit the project.
2022-03-16 Added design/CAD stuff (unfinished)
2022-03-16 Made the CAD stuff its own subsection, to draw more attention to the work done.
2022-03-17 Redesigned headings of current progress section
2022-03-25 Added audio shield test code
    - Plays short mp3 file that has been uploaded to TinyPICO SPIFFS.
    [audioTest.ino, tapStepCounter.ino]
2022-03-29 Got tap detection working with I2C for use with Audio shield
    - Edited code in the ADXL library I was using that was stopping I2C from
    working.
2022-03-30 Got audio playing from SD card when reminder is due to be fired.
    - Utilising more difficult library, I've managed to get file copy from
    SD card to SPIFFS to take a few seconds.
    - System now detects when a patient is moving and plays the audio. This
    will be changed ASAP to be on the second device and played when the
    second device receives a patient walking notification.
2022-03-31 Completed first prototype without vibration motor!
    - Implemented comms system with wearable device.
    - Wearable device now sends a message when a reminder might need to
    be played.
    - Implemented comms system, audio system and tap detection system on
    walking aid device.
    - Walking aid device continuously checks for taps, each time one is
    detected it updates the time the last tap took place.
    - If a tap was detected more than 5 seconds ago, we give the user
    the opportunity to apply a tap in the next 5 seconds.
    - If no tap detected in those 5 seconds either, the audio is played.
    [walkingAidDevice.ino, wearableDevice.ino]
2022-03-31 Cleaned up some code on walking aid device
2022-04-04 Finished cleaning up class diagrams for UML section
    - Completed wearable device class diagram
    - Completed walking aid device class diagram
2022-04-05 Begun development of Milestone 3 document
    - Started writing details on design decisions made for our devices.
2022-04-09 Started UML and class documentation section.
    - Organisation is all wrong I know.
    [SDToSPIFFS.cpp, SDToSPIFFS.h]
2022-04-10 Added more to design
    - Completed documentation section for walking aid device.
    - Completed class diagram section for walking aid device.
    - Started activity diagram section for walking aid device.
2022-04-12 Begun development of testing document.
    - Added test cases for both devices booting.
    - Added initial test cases for the initialisation of hardware.
    - 1) Test case of debugging LED when ESP-Now init fails.
    - 2) Test case of debugging LED when adding peer for comms fails.
    - Adjusted code for wearable device. Design section needs updating to
    reflect this.
    [DebugLED.cpp, DebugLED.h, WearableCommunications.cpp, WearableCommunications.h, walkingAidDevice.ino]
2022-04-13 Added more tests and adjusted code for tests.
    - Added DebugLED class to walking aid device to allow for LED debugging
    on device start up.
    - Adjusted some of the SD card code to ensure that the user can identify
    if initialisation or file reading has failed.
    - Added tests to the testing section.
    [DebugLED.cpp, DebugLED.h, SDToSPIFFS.cpp, SDToSPIFFS.h, WalkAidAudio.cpp, WalkAidCommunications.cpp, WalkAidCommunications.h, WearableCommunications.cpp]
2022-04-14 Added CAD/Prototype section (more coming)
2022-04-14 Added more prototype related stuff/unfinished, more to add
2022-04-17 Added usermanual + template
    Required Pygments package, gitignore also shit the bed
2022-04-19 Completed user manual pending other people checking over it.
    - Completed quick start guide.
    - Took lots of previous heavy content from quick start guide and put it
    into user guide.
    - Completed user guide.
    - Completed developer guide.
    - Added instructions for wiring.
    - Included images of hardware pinouts.
    - Included discussion on the code we developed and how future
    developers can adjust it to potentially improve the system.
2022-04-19 Added more work
    - Added content to narrative account section.
    - Added vibrator code.
    [wearableDevice.ino]
2022-04-21 Added more content to narrative section
    - Added more problems faced and solutions we used.
    - Wrote concluding remarks to narrative section.
    [new_accel_lib.cpp]
2022-04-23 Completed narrative account section.
    - Completed narrative on how we developed each stage of the project.
    - Moving on to work on reflection section next.
2022-04-23 Added wearable device pictures to tex + more
2022-04-24 Added power section + more images
    Also fixed alphabetical last name order in title page
